Nicoop/CNC_Laser_micro/Documentation/Entregables/LaTeX files/main.tex

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

%% Packages
\usepackage{amsmath}
\usepackage{lmodern}
\setlength{\headheight}{38pt}
\addtolength{\topmargin}{-20pt}
\usepackage{tabularx}
\usepackage{graphicx}
\usepackage[spanish,es-nodecimaldot]{babel}
\usepackage{tikz}
\usetikzlibrary{arrows.meta,positioning,shapes.geometric}
\usepackage{pdflscape}
\usepackage{xurl}
\usepackage[section]{placeins}
\usepackage{textcomp}
\addto\captionsspanish{\renewcommand{\refname}{Referencias}\renewcommand{\tablename}{Tabla}}

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

\begin{document}

%% Abstract and keywords must be defined BEFORE \maketitle
\begin{abstract}

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

\end{abstract}

%% Maketitle creates full-width header with abstract and keywords, then starts two-column layout
\maketitle
\normalsize

\onecolumn
\raggedbottom
\setlength{\emergencystretch}{1.5em}
{\small\setlength{\parskip}{0pt}\tableofcontents}
\clearpage
% \twocolumn

\newpage

\section{Introducción y objetivos}
\label{sec:introduccion}

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

\subsection{Objetivo general}

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

\subsection{Objetivos específicos}

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

% ============================================================================= %
\section{Descripción general del sistema}

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

% ============================================================================= %

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

\section{Sistema mecánico, hardware e interfaces eléctricas}
\label{sec:hardware}

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

\begin{figure}[htbp]
    \centering
    
    
    \caption{Diseño mecánico de referencia y recorrido de correas CoreXY~\cite{estructura_thingiverse}. Las imágenes ilustran la arquitectura adoptada; no constituyen fotografías del prototipo láser ni representan su mecanismo Z definitivo.}
    \label{fig:armadura}
\end{figure}

\subsection{Microcontrolador seleccionado}

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

\begin{figure}[htbp]
    \centering
    
    
    \caption{Esquema funcional de las dos bobinas de un motor bipolar. Las letras identifican extremos de bobina; no establecen el orden de terminales ni los colores del motor instalado.}
    \label{fig:NEMA17}
\end{figure}

\subsection{Láser seleccionado}

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

Las principales características declaradas
por el fabricante se presentan en
la Tabla~\ref{tab:caracteristicas_laser}.

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

\subsection{Drivers seleccionados}
\label{subsec:drivers}

\subsubsection{TB6600 -- Accionamiento de los motores}

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

\paragraph{Interfaz de comando.}

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

\paragraph{Configuración de corriente y micropasos.}

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

\paragraph{Características eléctricas.}

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

\begin{figure}[htbp]
    \centering
    
    \hspace{2cm}
    
    \caption{Aspecto ilustrativo de un módulo TB6600. El conexionado de la CNC se presenta en la Figura~\ref{fig:esquematico-electrico}.}
    \label{fig:TB6600}
\end{figure}

\subsubsection{P-DA-01 -- Interfaz del láser}

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

\subsection{Conexiones eléctricas}

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

\clearpage

% ============================================================================= %
\section{Arquitectura del firmware}
\label{sec:arquitectura}

\subsection{Organización modular}

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

\subsection{Inicialización y programa principal}

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

\subsection{Representación de los estados de operación}

El funcionamiento de la aplicación se representa mediante
el diagrama unificado de la Figura~\ref{fig:flujo-firmware}.
Se trata de un modelo funcional obtenido a partir del flujo
de control y de las banderas del programa; no corresponde
a una máquina de estados implementada mediante una única
variable de estado.

El recorrido principal comprende la inicialización,
el servicio del bucle y el procesamiento de las líneas
recibidas. Antes de interpretar cada línea se reconoce
el comando \texttt{\$X} y se comprueba la bandera de alarma.
Con alarma activa, las demás líneas son rechazadas.
El bucle continúa atendiendo los mensajes de estado
y bienvenida, así como la recepción UART. Las llamadas
bloqueantes de movimiento y referenciación retornan
al punto desde el que fueron invocadas.

La atención de un final de carrera es asíncrona.
Fuera del \textit{homing}, cuando la entrada permanece
activa durante la comprobación de 200~\textmu s,
se solicita detener los movimientos, se deshabilitan
el láser y los motores, se descarta el segmento pendiente
y se activa la alarma. La línea discontinua del diagrama
indica la modificación de esta condición; no representa
un salto del programa principal hacia otro bucle
de ejecución.

El retorno de la interrupción permite continuar
el contexto interrumpido. Por ello, el bloqueo de nuevas
líneas no equivale a cancelar todo el procesamiento
de una instrucción ya iniciada. Además, la ejecución
por tiempo de espera del segmento pendiente no comprueba
por sí misma la bandera de alarma. Estas particularidades
delimitan el alcance de la protección implementada
y justifican revisar la inhibición del movimiento
en todas las rutas de ejecución ante una alarma.

\begin{landscape}
    \begin{figure}[p]
        \centering

        \resizebox{\linewidth}{!}{%
            \input{attachments/estados-firmware}%
        }

        \caption{Diagrama funcional unificado del firmware.
        Las flechas continuas representan el flujo principal;
        el enlace discontinuo muestra el efecto de la
        interrupción de límite sobre la condición de alarma.
        Las operaciones agrupadas en el bloque de procesamiento
        se ejecutan según la instrucción recibida.}

        \label{fig:flujo-firmware}
    \end{figure}
\end{landscape}
% ============================================================================= %

\section{Comunicación e interpretación de G-code}
\label{sec:comunicacion}

\subsection{Generación y envío de instrucciones mediante LaserGRBL}

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

\subsection{Comunicación serie y tratamiento de mensajes}

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

\subsection{Interpretación de las instrucciones}

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

\subsection{Comandos reconocidos y estado modal}

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

\subsection{Anticipación de segmentos mediante lookahead}
\label{subsec:lookahead}

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

\[
c = \hat{\mathbf{d}}_{\mathrm{pendiente}}
    \cdot \hat{\mathbf{d}}_{\mathrm{nuevo}}.
\]

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

\subsection{Alcance de la compatibilidad con LaserGRBL}

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

% ============================================================================= %
\section{Generación y coordinación del movimiento}
\label{sec:movimiento}

\subsection{Cinemática y elección del mecanismo CoreXY}

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

\paragraph{Criterios de elección.}

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

\paragraph{Principio de funcionamiento.}

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

La transformación cinemática directa
se expresa como:

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

\paragraph{Transformación de las consignas.}

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

\paragraph{Ventajas y limitaciones.}

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

\subsection{Conversión de desplazamientos en pulsos}

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

Para una polea dentada, el factor se calcula mediante:

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

\begin{equation}
    K_s =
    \frac{200 \times 16}{20 \times 2}
    = 80\,\mathrm{pulsos/mm}.
\end{equation}

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

A partir del desplazamiento solicitado, las cantidades
de pulsos con signo se determinan como:

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

\subsection{Interpolación y sincronización de los motores}

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

\begin{equation}
    N_A = 1200,
    \qquad
    N_B = 400.
\end{equation}

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

\subsection{Temporización y perfil de velocidad}

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

\begin{equation}
    v = \frac{F}{60}.
\end{equation}

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

La longitud del desplazamiento solicitado se obtiene
mediante:

\begin{equation}
    L = \sqrt{(\Delta x)^2 + (\Delta y)^2}.
\end{equation}

Para una velocidad cartesiana nominal $v$, la
frecuencia de eventos del motor principal resulta:

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

\begin{equation}
    v_p^2 = 2a_p n,
\end{equation}

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

\subsection{Ejecución del barrido de grabado}

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

\subsection{Movimiento independiente del eje Z}

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

\subsection{Resolución y exactitud del posicionamiento}

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

% ============================================================================= %
\section{Referenciación, límites y control del láser}
\label{sec:referenciacion-laser}

\subsection{Referenciación de los ejes}

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

\subsection{Finales de carrera y bloqueo por alarma}

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

\subsection{Límites del espacio de trabajo}

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

\subsection{Accionamiento y modulación del láser}

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

% ============================================================================= %
\section{Ensayos y resultados}
\label{sec:ensayos}

\subsection{Alcance de las pruebas}

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

\subsection{Referenciación y respuesta a límites}

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

\subsection{Prueba de grabado}

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

\subsection{Síntesis de los resultados}

La Tabla~\ref{tab:resultados-observados} resume
las comprobaciones disponibles y el alcance
de sus conclusiones.

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

% ============================================================================= %
\section{Limitaciones y conclusiones}
\subsection{Limitaciones y alcance de la validación}
\label{subsec:limites-validacion}

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

\subsection{Mejoras previstas}

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

\subsection{Conclusiones}
\label{subsec:conclusiones}

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

% ============================================================================= %

% Agradecimientos: incorporar solamente si corresponde al proyecto.

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

\end{document}
