Nicoop/CNC_Laser_micro/Documentation/main.pdf

Facultad de Ingeniería - UNCuyo | Mendoza, Argentina

INFORME DE PROYECTO

# Diseño e implementación de una CNC láser controlada mediante una placa NUCLEO-F446RE

Nicolas Patricelli¹

Federico Barrios Retta²

1Facultad de Ingeniería, Universidad Nacional de Cuyo, Argentina 2Facultad de Ingeniería, Universidad Nacional de Cuyo, Argentina

Resumen

Se presenta el diseño y la implementación de una CNC láser basada en una placa NUCLEO-F446RE. El firmware interpreta instrucciones G-code enviadas desde LaserGRBL, coordina el movimiento CoreXY y el eje Z mediante motores paso a paso y genera el mando PWM del cabezal. Se describen la estructura mecánica, las interfaces eléctricas, la organización modular, la referenciación y el tratamiento de límites. Las pruebas funcionales permitieron completar el homing de los tres ejes, observar la detención ante finales de carrera y obtener un grabado sobre MDF de 5 mm de espesor nominal. La validación disponible es cualitativa: no se determinaron valores de exactitud o repetibilidad y no se considera validada la capacidad de corte. Se identifican las limitaciones de la implementación y las mejoras de protección, acondicionamiento y diagnóstico previstas.

1

UNCUYO – Ingeniería Mecatrónica Mendoza – Argentina

[Microcontroladores y Electrónica de Potencia] Proyecto Integrador de la Materia

Prof. Titular: Eduardo Iriarte Prof. JTP: Martín
Alumnos: Patricelli Nicolas, Barrios Retta Federico

Índice

1. Introducción y objetivos | 3
2. Descripción general del sistema | 3
3. Sistema mecánico, hardware e interfaces eléctricas | 4
4. Arquitectura del firmware | 12
5. Comunicación e interpretación de G-code | 16
6. Generación y coordinación del movimiento | 19
7. Referenciación, límites y control del láser | 23
8. Ensayos y resultados | 25
9. Limitaciones y conclusiones | 26

### 1. Introducción y objetivos

El grabado mediante láser requiere que el desplazamiento relativo entre la herramienta y la pieza sea coordinado con el accionamiento del láser. Para ejecutar una trayectoria definida, deben ser interpretadas las instrucciones de trabajo y generadas las señales que gobiernan los actuadores de la máquina.

En el marco de la asignatura Microcontroladores y Electrónica de Potencia, se desarrolló el control de una CNC destinada al grabado y corte láser. El proyecto permite integrar los contenidos relacionados con la programación de sistemas embebidos, la comunicación serie, la utilización de sensores y el accionamiento de motores paso a paso.

### 1.1. Objetivo general

Diseñar e implementar un sistema de control basado en un microcontrolador para ejecutar trayectorias de grabado mediante láser a partir de instrucciones enviadas desde una computadora.

### 1.2. Objetivos específicos

Se plantean como objetivos específicos la interpretación de las instrucciones de trabajo, la coordinación de los desplazamientos en el plano de grabado, el ajuste de la distancia relativa entre el láser y la pieza, y la regulación del accionamiento del láser durante la ejecución de las trayectorias.

Asimismo, se busca establecer una referencia de posición mediante sensores de fin de carrera y verificar el funcionamiento del sistema mediante ensayos de movimiento y grabado.

### 2. Descripción general del sistema

La máquina desarrollada consiste en un sistema de control numérico computarizado (CNC) destinado al grabado y al corte mediante láser. Durante estos procesos, el cabezal es desplazado respecto de la pieza siguiendo una trayectoria definida por instrucciones G-code, mientras que el accionamiento del láser es coordinado con el movimiento.

El posicionamiento del cabezal en el plano X–Y se realiza mediante un mecanismo de cinemática CoreXY, accionado por dos motores paso a paso. Se incorpora, además, un eje Z que permite desplazar el cabezal para ajustar la distancia entre el módulo láser y la superficie de trabajo. El eje Z es accionado de manera independiente de los desplazamientos coordinados en el plano X–Y.

Las trayectorias de trabajo son definidas mediante un archivo G-code generado en una computadora. Las instrucciones son transmitidas al microcontrolador STM32 de una placa NUCLEO-F446RE, donde son interpretadas para generar las señales de paso, dirección y habilitación de los drivers de los motores. Asimismo, se genera una señal de modulación por ancho de pulso (PWM) destinada a comandar el accionamiento del módulo láser.

El sistema incorpora finales de carrera para establecer una referencia de posición mediante un procedimiento de referenciación o homing. A partir de dicha referencia, los desplazamientos son determinados mediante las consignas y los pasos comandados a los motores. El posicionamiento se realiza en lazo abierto, sin medición continua de la posición del cabezal.

La Figura 1 resume los bloques funcionales y distingue las consignas de movimiento, el mando del láser y las entradas de referencia.

Computadora LaserGRBL; NUCLEO-F446RE Firmware propio; Tres TB6600 Canales A, B y Z; STEP / DIR / ENA; Cuatro motores Dos CoreXY y dos Z; P-DA-01 Interfaz del láser; LT-40W-F23 Cabezal láser; Tres finales de carrera X, Y y Z; UART USB; GPIO; bobinas; PWM

Figura 1. Bloques funcionales de la CNC. Las conexiones de potencia y las referencias eléctricas se detallan en la Figura 8.

### 3. Sistema mecánico, hardware e interfaces eléctricas

### 3.1. Armadura de la CNC

La armadura se construyó a partir del diseño Core XY, publicado por Javierarnedo en Thingiverse [1]. Se conservaron los perfiles y la configuración del bastidor. No se dispone de un relevamiento dimensional del montaje; los límites configurados en el firmware no se utilizan como medidas del bastidor ni como recorridos útiles comprobados.

Se utilizaron perfiles ranurados de aluminio, dispuestos en dos marcos rectangulares unidos mediante cuatro montantes. Las uniones atornilladas y las escuadras permiten fijar los soportes de guiado y transmisión. La alineación del bastidor y la ausencia de holguras en las uniones condicionan la geometría del recorrido.

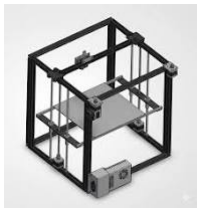
[picture p27: figure]
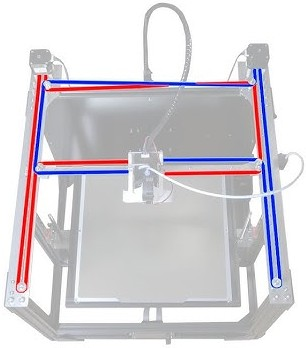
[picture p28: figure]

Figura 2. Diseño mecánico de referencia y recorrido de correas CoreXY [1]. Las imágenes ilustran la arquitectura adoptada; no constituyen fotografías del prototipo láser ni representan su mecanismo Z definitivo.

### 3.2. Microcontrolador seleccionado

El sistema de control fue implementado mediante una placa de desarrollo NUCLEO-F446RE, que incorpora un microcontrolador STM32F446RET6 de la familia STM32F4. Este dispositivo dispone de un núcleo Arm Cortex-M4 de 32 bits, con unidad de punto flotante de precisión simple, 512 KB de memoria Flash y 128 KB de memoria SRAM [9].

La unidad de punto flotante proporciona soporte para las operaciones aritméticas empleadas en el procesamiento de coordenadas y en los cálculos de movimiento. Aunque el microcontrolador admite una frecuencia máxima de 180 MHz, en la configuración del proyecto se utiliza un reloj de sistema de 84 MHz.

Para la temporización del movimiento se utilizan los temporizadores TIM2 y TIM4, asociados a la generación de pasos de los motores del mecanismo CoreXY y del eje Z, respectivamente. El canal 1 del temporizador TIM3 se utiliza para generar la señal PWM que comanda el módulo láser.

La comunicación con la computadora se realiza mediante USART2, configurada a 115200 bit/s. La interfaz de puerto serie virtual de la placa permite establecer esta comunicación a través de la conexión USB del ST-LINK. Asimismo, este dispositivo integrado permite programar y depurar el microcontrolador durante el desarrollo.

Las señales de paso, dirección y habilitación de los drivers se generan mediante pines GPIO. También se utilizan entradas digitales para recibir las señales de los finales de carrera. Los conectores de expansión de la placa permiten acceder a los pines necesarios para estas interfaces.

La disponibilidad de temporizadores, comunicación serie, salidas PWM y pines de entrada y salida permite concentrar en un mismo microcontrolador la interpretación de instrucciones, la coordinación del movimiento y el comando de los actuadores.


Figura 3. Referencia mecánica de la placa NUCLEO-64 y asignación de conectores. Para el proyecto se utiliza la variante F446RE; las señales empleadas se reúnen en la Tabla 4.

### 3.3. Motores seleccionados

Para el accionamiento de la máquina se utilizaron cuatro motores paso a paso bipolares de tamaño de brida NEMA 17, marca Usongshine, modelo 17HS3401.

Dos motores accionan el mecanismo CoreXY, correspondientes a los canales A y B. Los otros dos se utilizan para el desplazamiento del eje Z y se conectan en paralelo a un mismo driver.

Cada motor dispone de dos bobinas, cuyo accionamiento requiere invertir el sentido de la corriente para establecer la secuencia de excitación. Esta función es realizada por los módulos TB6600, mientras que el microcontrolador genera las señales de paso, dirección y habilitación.

La denominación NEMA 17 identifica el tamaño de la brida de montaje y no determina por sí sola la corriente nominal, el ángulo de paso ni el par disponible. No se dispone de la ficha específica de corriente y par del ejemplar instalado; estos datos no se deducen del tamaño de brida.

Tabla 1. Identificación y características de los motores utilizados.

Parámetro | Identificación o valor
Marca | Usongshine
Modelo | 17HS3401
Tamaño de brida | NEMA 17
Tipo de accionamiento | Bipolar, dos fases
Cantidad instalada | Cuatro motores
Lote relevado | 202331120
Ángulo utilizado por el firmware | 1,8 ◦
Corriente y par nominales | Sin ficha específica disponible

En el firmware se utiliza un ángulo de paso de 1,8

◦
, equivalente a 200 pasos completos por revolución, y una subdivisión de

1/16 de paso. La conversión a pulsos por revolución y por milímetro se desarrolla en la Sección 6. Estos parámetros deben coincidir con el ángulo nominal del motor y con el ajuste de micropaso seleccionado en los drivers.

El ajuste eléctrico y su relación con la conexión de los motores se describen en la Subsección 3.5. No se dispone de un registro de las posiciones DIP utilizadas.

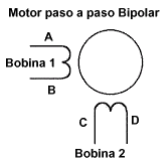
[picture p29: figure]

Figura 4. Esquema funcional de las dos bobinas de un motor bipolar. Las letras identifican extremos de bobina; no establecen el orden de terminales ni los colores del motor instalado.

### 3.4. Láser seleccionado

Como herramienta de trabajo se utiliza un módulo láser LASER TREE LT-40W-F23, destinado a operaciones de grabado y corte. El conjunto integra el emisor láser, la óptica de enfoque, la electrónica de accionamiento y un sistema de refrigeración mediante disipador y ventilador.

Según la documentación del fabricante [2], su potencia óptica es de 5 ± 1 W y su longitud de onda es de 450 ± 10 nm, correspondiente a la región azul del espectro visible. La denominación LT-40W-F23 identifica el modelo y no debe interpretarse como una potencia óptica de 40 W.

Las principales características declaradas por el fabricante se presentan en la Tabla 2.

Tabla 2. Características declaradas del módulo láser LASER TREE LT-40W-F23.

Parámetro | Especificación
Potencia óptica | 5 ± 1 W
Longitud de onda | 450 ± 10 nm
Tensión de alimentación | 12 V CC
Corriente de entrada | 1,5–2 A
Distancia de enfoque declarada | 23 mm
Frecuencia de modulación | Hasta 5 kHz
Nivel de mando indicado | 0/5–12 V
Temperatura de operación | 0–60 ◦C
Conector | XH2.54 de tres terminales
Masa del módulo | 230 g

La interfaz del cabezal utiliza tres conductores: alimentación positiva, referencia GND y entrada PWM. Esta disposición permite mantener la alimentación del módulo y modificar su accionamiento mediante la señal de control, sin utilizar la salida del microcontrolador para suministrar la corriente del emisor.

El cabezal se encuentra montado sobre el mecanismo de desplazamiento del eje Z. Este movimiento permite ajustar su posición respecto de la pieza para establecer la condición de enfoque. Para el grabado, el fabricante indica que el foco debe situarse sobre la superficie del material. La referencia mecánica utilizada para realizar ese ajuste debe respetar las indicaciones de montaje del módulo.

El accionamiento se establece mediante PWM; los modos y la relación entre consigna y salida se desarrollan en la Sección 7. La potencia óptica indicada en la tabla es un dato del fabricante, no una medición del proyecto.


Figura 5. Cabezal LT-40W-F23, accesorios y dimensiones de referencia del fabricante. Estas imágenes de producto no son fotografías del montaje experimental.

La posibilidad de grabar o cortar una pieza depende del material, su espesor, el enfoque, la velocidad de avance y la consigna de accionamiento. Por ello, las prestaciones de la máquina deben establecerse mediante ensayos, sin deducirse únicamente de la potencia nominal del cabezal.

### 3.5. Drivers seleccionados

### 3.5.1. TB6600 – Accionamiento de los motores

Para el accionamiento de los motores paso a paso se utilizaron módulos driver comercializados como TB6600. Su función consiste en recibir las señales de comando generadas por el microcontrolador y establecer la excitación de los bobinados necesaria para producir el movimiento.

Mediante estos módulos se distingue la generación de las consignas de movimiento del suministro de energía a los motores. El microcontrolador determina la cantidad de pulsos, su frecuencia y el sentido de desplazamiento, mientras que el driver gobierna las corrientes de los bobinados a partir de su alimentación de potencia.

Interfaz de comando. El movimiento se comanda mediante las entradas PUL y DIR. Cada pulso válido recibido en PUL produce un avance en la secuencia de excitación, cuya magnitud depende de la subdivisión de pasos seleccionada. La entrada DIR establece el sentido de avance de dicha secuencia. Además, se dispone de una entrada ENA para controlar la habilitación del accionamiento.

Las entradas de comando se presentan mediante pares de terminales PUL+/PUL-, DIR+/DIR- y ENA+/ENA-. Según las especificaciones disponibles, estas entradas son optoacopladas y están destinadas a señales de 5 V, con una corriente de señal comprendida entre 8 y 15 mA. Por lo tanto, su conexionado debe considerar tanto la tensión aplicada como la corriente requerida por la interfaz de entrada.

Configuración de corriente y micropasos. El módulo permite seleccionar la corriente de salida mediante interruptores DIP. Este ajuste establece el nivel de corriente utilizado para la excitación de los bobinados y debe determinarse a partir de las características del motor conectado. La corriente máxima admitida por el driver no constituye, por sí sola, el valor que debe utilizarse en el proyecto.

También puede seleccionarse la subdivisión de pasos. En el funcionamiento por micropasos, las corrientes de los bobinados son modificadas para generar posiciones intermedias entre los pasos completos del motor. Esto permite incrementar la cantidad de pulsos requeridos por vuelta y reducir el incremento angular nominal asociado a cada pulso.

La posición de los interruptores debe corresponder a la subdivisión utilizada por el firmware. En Z, la corriente del driver se reparte entre los dos motores conectados en paralelo; por ello, el ajuste debe considerar las dos ramas y no solamente un motor. La conversión de micropasos a desplazamiento se desarrolla en la Sección 6.

Características eléctricas. En la Tabla 3 se resumen las especificaciones recopiladas para el módulo. La alimentación del montaje se documenta en el esquema de conexiones. Los demás valores proceden de la información comercial recopilada; no se dispone de una ficha que identifique la versión del módulo ni de un registro de sus ajustes DIP.

Parámetro | Valor declarado
Tensión de alimentación de potencia | 9–42 V CC
Intervalo de corriente de salida | 0,7–4,0 A
Niveles de corriente seleccionables | 8
Frecuencia máxima de pulsos de entrada | Hasta 20 kHz
Tensión de las señales de entrada | 5 V
Corriente de las señales de entrada | 8–15 mA
Pulsos por vuelta para un motor de 1,8
- 200–6400
Aislamiento de las entradas | Optoacoplado
Protecciones declaradas | Sobrecorriente y sobretemperatura

Tabla 3. Especificaciones recopiladas del módulo TB6600 según la información comercial aportada. No se identifica la revisión del módulo ni si la corriente declarada es pico o eficaz.

La frecuencia de PUL gobierna la velocidad de la secuencia de excitación. El límite de 20 kHz es un dato declarado para el módulo, no una velocidad experimental de la CNC; el par disponible también depende de la alimentación, la corriente y la velocidad.


Figura 6. Aspecto ilustrativo de un módulo TB6600. El conexionado de la CNC se presenta en la Figura 8.

### 3.5.2. P-DA-01 – Interfaz del láser

La conexión entre el sistema de control, la alimentación y el cabezal láser se realiza mediante una placa adaptadora P-DA-01. Su función es facilitar la interconexión de estos elementos mediante conectores de alimentación y de señal TTL/PWM.

Debe distinguirse esta placa del driver propio del cabezal, encargado del accionamiento del diodo láser. La P-DA-01 constituye una interfaz de conexión y distribución de alimentación [2]; la documentación disponible no permite atribuirle funciones de regulación de corriente ni de aislamiento galvánico.

La placa dispone de distintas entradas para adaptar el conexionado de la unidad de control y de salidas de tres terminales hacia el módulo láser. Estas últimas comprenden la alimentación positiva, la referencia GND y la señal de mando PWM. También incorpora una entrada de alimentación externa de corriente continua y un selector EXT/INT, mediante el cual se selecciona la alimentación externa o la procedente del conexionado de entrada. Dos indicadores luminosos permiten comprobar la presencia de alimentación y de la señal de control.

En el firmware del proyecto, la señal de mando del láser es generada por el canal 1 del temporizador TIM3 y se encuentra asignada al pin PC6 del microcontrolador. Su frecuencia es de 1 kHz y su ciclo de trabajo se modifica para establecer la consigna de accionamiento del cabezal. La alimentación del láser es suministrada por la fuente de la máquina, mientras que la salida del microcontrolador proporciona únicamente la señal de mando.


Figura 7. Interfaz P-DA-01 y descripción ilustrativa de sus conexiones. La cantidad de terminales puede variar entre revisiones; el orden del montaje no se deduce únicamente de la imagen

### 3.6. Conexiones eléctricas

Las interconexiones entre la placa de desarrollo, los drivers de los motores, los finales de carrera y el módulo de accionamiento del láser se representan en la Figura 8. El esquema fue elaborado en KiCad e identifica los terminales de los módulos, las redes de alimentación y las señales de control utilizadas por el firmware.

Distribución de la alimentación. Se dispone de una fuente con entrada de 220 V de corriente alterna y salidas de 24 V, 12 V y 5 V de corriente continua. La salida de 12 V también se representa como alimentación del cabezal, en correspondencia con la tabla específica del LT-40W-F23. Aunque los diagramas genéricos del manual mencionan 12/24 V, esa indicación no se interpreta como autorización para alimentar este modelo con 24 V. La alimentación de potencia de los drivers TB6600 se realiza mediante la salida de 12 V, con los tres módulos conectados en paralelo. La placa NUCLEO-F446RE se alimenta desde la computadora mediante la conexión USB del ST-LINK, que también proporciona el puerto serie virtual.

En el esquema se distinguen las alimentaciones de potencia, las tensiones utilizadas por las interfaces de control y sus correspondientes retornos. Las uniones entre referencias eléctricas se representan según el cableado del sistema.

Interfaz con los drivers de los motores. El accionamiento de los motores es comandado mediante señales de paso, dirección y habilitación. Las señales de paso y dirección son independientes para los canales A, B y Z, mientras que la habilitación es compartida por los tres drivers.

El cableado documentado en el firmware corresponde a una conexión de ánodo común: los terminales PUL+, DIR+ y ENA+ se conectan a 3,3 V, y los terminales negativos reciben las señales de los GPIO. La correspondencia entre señales y pines se presenta en la Tabla 4. El uso de 3,3 V difiere del nivel comercial declarado de 5 V para los TB6600. Sin el circuito de entrada de la versión instalada ni mediciones de corriente y umbral, no se afirma que el conexionado proporcione los márgenes eléctricos requeridos.

Conexión de los motores. Cada motor bipolar dispone de dos bobinas. Los terminales A+ y A- del driver se conectan a los extremos de una bobina, y los terminales B+ y B-, a los extremos de la otra.

Los motores CoreXY se identifican como M1 (A) y M2 (B) en el esquema. Cada uno dispone de un driver; estas letras deben distinguirse de A+/A- y B+/B-, que identifican las bobinas. Para el eje Z, el firmware documenta dos motores conectados en paralelo a un mismo driver. El esquema muestra las ramificaciones de cada salida hacia M3 y M4, correspondientes a los dos motores de Z.

Tabla 4. Asignación de señales de control y entradas de límite en la NUCLEO-F446RE.

Señal | GPIO | Destino o procedencia
STEP_A | PC0 | PUL- del driver A
DIR_A | PC1 | DIR- del driver A
STEP_B | PC2 | PUL- del driver B
DIR_B | PC3 | DIR- del driver B
STEP_Z | PC4 | PUL- del driver Z
DIR_Z | PC5 | DIR- del driver Z
MOTOR_EN | PC7 | ENA- de los tres drivers
LIMIT_X | PB0 | Señal del final de carrera X
LIMIT_Y | PB1 | Señal del final de carrera Y
LIMIT_Z | PB2 | Señal del final de carrera Z
LASER_PWM | PC6 | Entrada de control del módulo láser

Interfaz con los finales de carrera. Se utilizan tres señales de límite, correspondientes a X, Y y Z, conectadas a PB0, PB1 y PB2, respectivamente. Los módulos de final de carrera se representan mediante sus terminales de alimentación, masa y señal, conservando la identificación del conector utilizado.

El firmware configura estas entradas con resistencias internas de polarización a masa e interpreta un nivel bajo como la activación del límite. Por lo tanto, debe comprobarse que la salida de los módulos presente el nivel de reposo y de activación esperado por el programa. El esquema identifica alimentación de 3,3 V, masa y señal. No se dispone de la identificación exacta del módulo ni de un relevamiento del orden de terminales; el funcionamiento observado no sustituye esa caracterización.

Interfaz con el accionamiento del láser. La señal de control del láser se genera mediante el canal 1 de TIM3 y se obtiene en PC6, disponible en el terminal 4 del conector CN10 de la NUCLEO-F446RE. Esta red se identifica como LASER_PWM.

La temporización del PWM se describe en la Sección 7. La red PC6 llega a la interfaz P-DA-01 y no directamente al diodo láser. El manual identifica una entrada PWM de 0/5–12 V, pero no especifica un umbral que garantice el reconocimiento de 3,3 V. No se dispone de una caracterización eléctrica de esta conexión; se registra como limitación en la Subsección 9.1.

# Tb6600 Signal High Voltage PUL+

# VCC U1

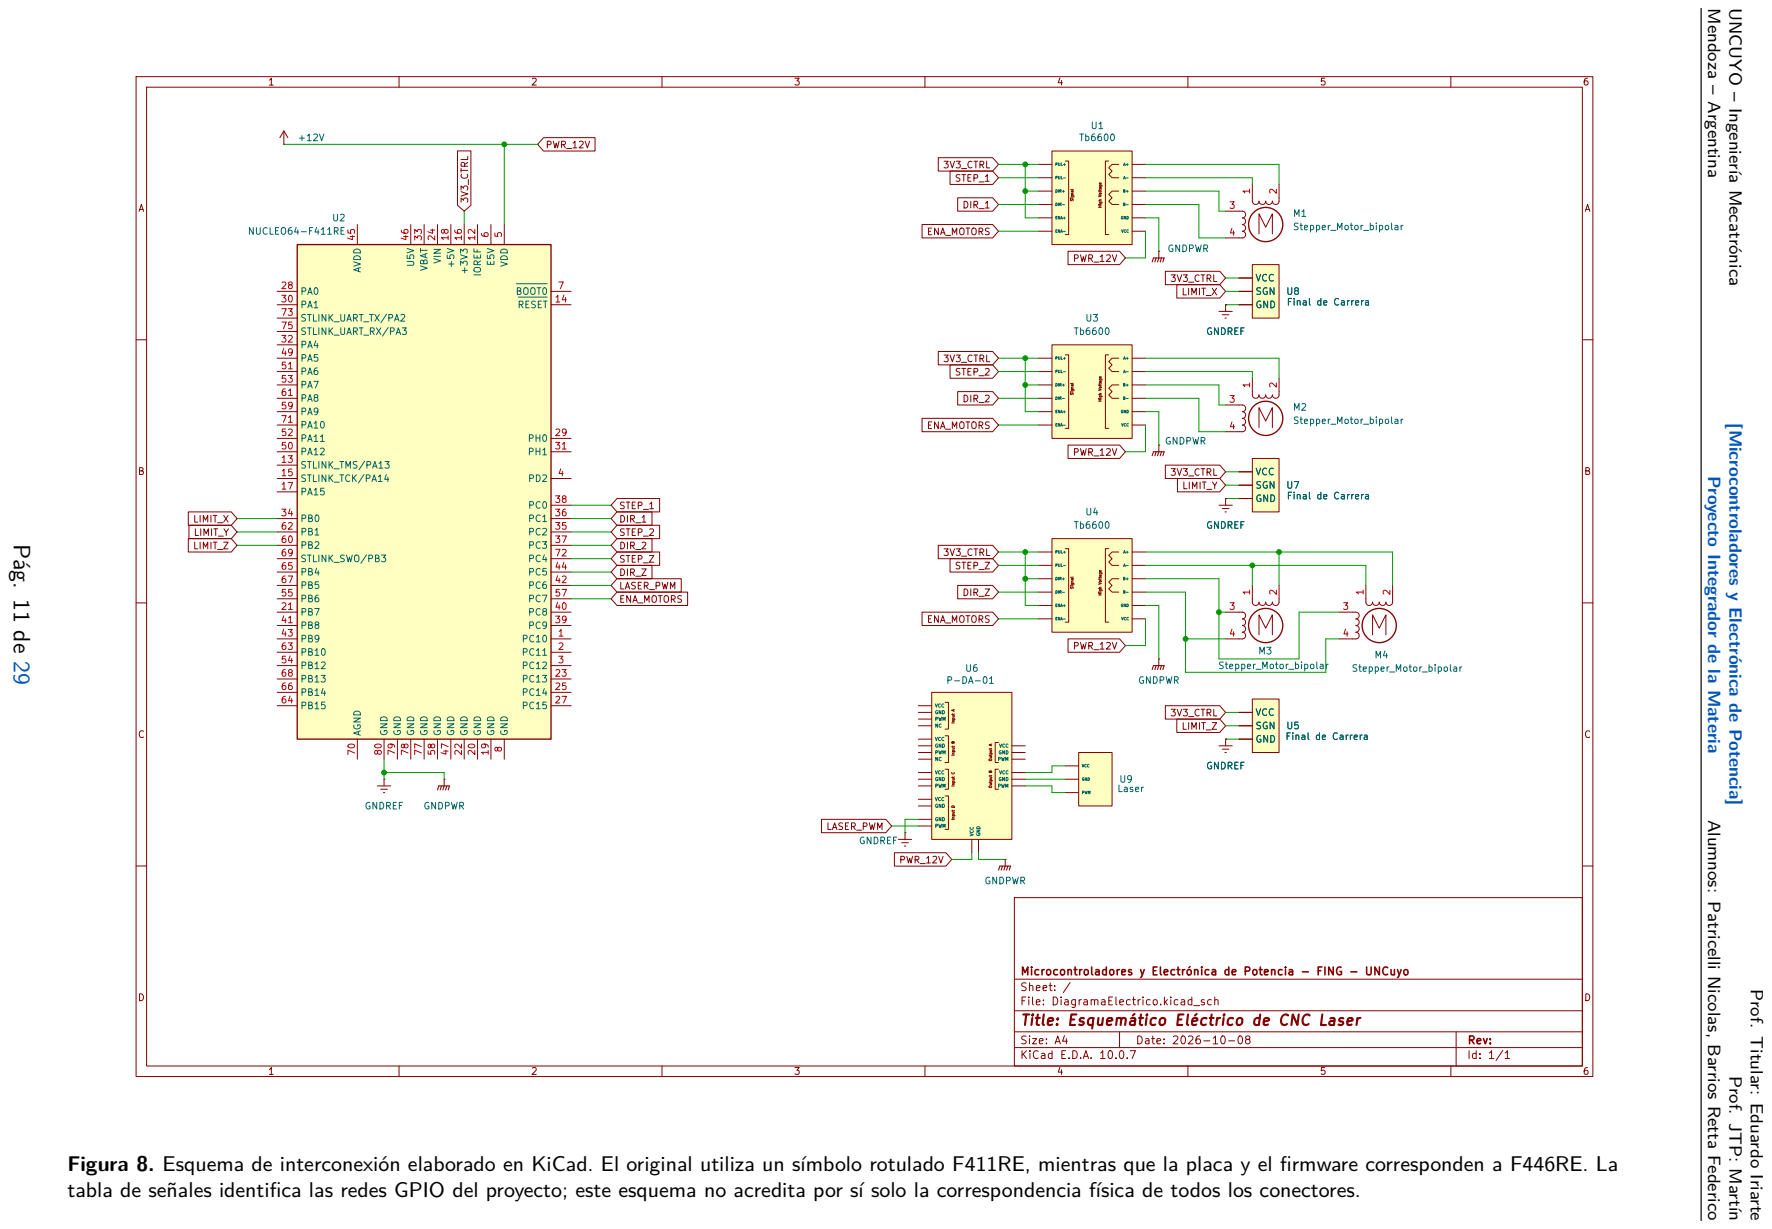
[picture p30: page 11]

UNCUYO – Ingeniería Mecatrónica [Microcontroladores y Electrónica de Potencia]

Alumnos: Patricelli Nicolas, Barrios Retta Federico 1 2 3 4 5 6 1 2 3 4 5 6 ABCD ABCD Date: 2026-10-08

Final de Carrera GNDPWR

Proyecto Integrador de la Materia

GNDREF Figura 8. Esquema de interconexión elaborado en KiCad. El original utiliza un símbolo rotulado F411RE, mientras que la placa y el firmware corresponden a F446RE. La tabla de señales identifica las redes GPIO del proyecto; este esquema no acredita por sí solo la correspondencia física de todos los conectores.

Sheet: /
File: DiagramaElectrico.kicad_sch
Title: Esquemático Eléctrico de CNC Laser
KiCad E.D.A. 10.0.7

Prof. Titular: Eduardo Iriarte

### 4. Arquitectura del firmware

### 4.1. Organización modular

El firmware fue desarrollado en lenguaje C mediante una organización modular. Las responsabilidades del sistema se distribuyen entre módulos de interpretación de instrucciones, generación de movimiento, referenciación, control del láser y habilitación de los drivers.

Los módulos funcionales se organizan mediante archivos de encabezado, en los que se declara su interfaz pública, y archivos de implementación, en los que se definen las operaciones correspondientes. Los encabezados de configuración reúnen constantes y asignaciones de pines, sin requerir necesariamente un archivo de implementación.

El estado interno y las funciones auxiliares de los módulos se mantienen, cuando corresponde, mediante declaraciones con el especificador static. En las declaraciones a nivel de archivo, este especificador establece enlace interno y evita que sus identificadores sean utilizados directamente desde otras unidades de compilación. De esta manera, el acceso al módulo se realiza mediante las funciones declaradas en su encabezado.

Las variables locales declaradas con static conservan su valor entre llamadas sucesivas. Este recurso es utilizado, por ejemplo, para recordar las condiciones de continuidad entre segmentos de movimiento. El ocultamiento del estado interno permite modificar su representación sin alterar la interfaz utilizada por los demás módulos.

Las dependencias funcionales se muestran en la Figura 10. Cada bloque representa un módulo C con una interfaz propia. Las marcas de visibilidad son una adaptación gráfica y no implican una implementación orientada a objetos.

La Figura 9 muestra una selección de archivos de la carpeta Code/, utilizada tanto en la copia local como en el repositorio revisado. El contraste se realizó con la revisión 0ce7b21, cuyo código fuente coincide con el utilizado en este informe [7].

Code/
|-- CNC_laser.ioc
|-- Core/
| | |-- Inc/
| | | | |-- main.h, corexy_config.h
| | | | |-- gcode_parser.h, homing.h
| | | | |-- stepper.h, z_axis.h
| | | | |-- laser.h, motor_enable.h, watchdog.h
| | | | ‘-- ... encabezados de soporte
| | |-- Src/
| | | | |-- main.c, gcode_parser.c
| | | | |-- stepper.c, z_axis.c, homing.c
| | | | |-- laser.c, motor_enable.c, watchdog.c
| | | | |-- stm32f4xx_it.c, stm32f4xx_hal_msp.c
| | | | ‘-- ... archivos de soporte
| | ‘-- Startup/
|-- Drivers/
| | |-- CMSIS/
| | ‘-- STM32F4xx_HAL_Driver/
|-- STM32F446RETX_FLASH.ld
‘-- STM32F446RETX_RAM.ld

Figura 9. Estructura seleccionada del proyecto de firmware. Se agrupan nombres en algunas filas y se abrevian los archivos de soporte y las bibliotecas.

Mendoza – Argentina

UNCUYO – Ingeniería Mecatrónica [Microcontroladores y Electrónica de Potencia]

Proyecto Integrador de la Materia

Prof. Titular: Eduardo Iriarte

Prof. JTP: Martín

Alumnos: Patricelli Nicolas, Barrios Retta Federico

MÓDULO C
gcode_parser
Interpretación de una línea de G-code

+ gcode_parse_line(...)

Salida: estructura GcodeCommand. La conversión numérica es interna.

MÓDULO C
main.c
UART, comandos, segmentos pendientes y alarmas

+ main()
- process_gcode_line(...)
- flush_pending_move(...)
- service_realtime()

MÓDULO C
motor_enable
Habilitación común de los drivers

+ motor_enable_init()
+ motors_enable()
+ motors_disable()
+ motors_are_enabled()

MÓDULO C
homing
Referenciación Z, X e Y; lectura de límites

+ homing_init()
+ homing_run()
+ homing_is_active()

Búsqueda directa: pulsos GPIO y DWT.

MÓDULO C
stepper
Movimiento CoreXY e interrupción de TIM2

+ stepper_init(...)
+ stepper_move_to(...)
+ stepper_get_position(...) + stepper_set_position(...) + stepper_emergency_stop()
+ stepper_timer_isr()
+ stepper_set_wait_callback(...)

MÓDULO C
z_axis
Movimiento Z e interrupción de TIM4

+ z_axis_init(...)
+ z_axis_move_to(...)
+ z_axis_get_position(...) + z_axis_set_position(...) + z_axis_emergency_stop()
+ z_axis_timer_isr()

MÓDULO C
watchdog
Supervisión mediante IWDG

+ watchdog_refresh()
+ watchdog_caused_last_reset()

MÓDULO C
laser
Accionamiento PWM mediante TIM3

+ laser_init(...)
+ laser_enable() / laser_disable() + laser_set_power(...)
+ laser_set_dynamic(...)
+ laser_begin_segment(...) + laser_set_speed_ratio(...)
analiza | habilita

ejecuta

modo, potencia y segmento mueve / fija cero

referenciación Z relación de velocidades

callback

refresca

Cómo leer la figura

Llamada a una interfaz
Servicio de supervisión

Invocación de callback

+ Interfaz expuesta por el módulo. - Operación interna de main.c. Se muestran operaciones seleccionadas y firmas abre-

viadas. La callback se ejecuta durante la espera del movimiento X–Y; stepper no depende de un encabe-
zado de main. Figura 10. Organización modular del firmware. Cada bloque identifica un módulo C, su responsabilidad y una selección de sus operaciones. Las flechas indican llamadas a

interfaces; se distinguen las dependencias de supervisión y la invocación mediante callback. Las firmas se presentan abreviadas.

Pág. 13 de 29

Coordinación de la aplicación: main.c. En este archivo se inicializan los periféricos y los módulos funcionales, y se implementa el bucle principal. También se construyen las líneas recibidas, se atienden los comandos especiales y se determinan las acciones correspondientes a las instrucciones G-code. Se conservan el modo de coordenadas, el avance modal, el segmento X–Y pendiente y las banderas asociadas a la comunicación y a la alarma.

Interpretación de instrucciones: gcode_parser. Este módulo transforma una línea de texto en una estructura GcodeCommand. En ella se identifican las coordenadas, el avance, el parámetro de accionamiento del láser y los comandos reconocidos. El módulo realiza la interpretación de la instrucción; la decisión sobre su ejecución y la conservación del estado modal corresponden a la aplicación principal.

Movimiento CoreXY: stepper. Se implementa la transformación de las consignas X–Y en desplazamientos de los motores A y B, junto con la coordinación de los pasos y el perfil de velocidad. El estado del movimiento y las posiciones lógicas se conservan internamente. La generación de pulsos es atendida mediante interrupciones de TIM2, mientras que la interfaz permite solicitar desplazamientos, consultar o establecer la posición lógica y detener el movimiento.

Movimiento del eje Z: z_axis. Se implementa el accionamiento del eje Z mediante consignas de posición y avance. El módulo conserva la posición lógica y el estado del desplazamiento, y actualiza los pasos mediante interrupciones de TIM4. Su ejecución es independiente del mecanismo de almacenamiento y continuidad de segmentos X–Y.

Referenciación: homing. Se implementa la secuencia de búsqueda de los finales de carrera en el orden Z, X e Y. La maniobra comprende una aproximación inicial, un retroceso, una segunda aproximación a menor velocidad y una separación final del contacto. Se utilizan las funciones de movimiento de los módulos CoreXY y Z, y se mantiene una bandera que identifica la ejecución de la referenciación.

Accionamiento del láser: laser. Se administra la habilitación del láser y la actualización del ciclo de trabajo de la señal PWM generada por TIM3. El parámetro S se limita al intervalo configurado y se convierte en un valor de comparación del temporizador. Se distingue entre la deshabilitación del láser y la anulación de su salida durante un movimiento rápido. En modo M4, stepper actualiza la relación entre la velocidad comandada y la de crucero para ajustar el PWM; no se mide la velocidad física.

Habilitación de los drivers: motor_enable. Se administra la señal común de habilitación de los tres drivers y se conserva su estado lógico. La interfaz permite habilitar, deshabilitar y consultar dicho estado, y es utilizada por la aplicación para atender los comandos M17 y M84.

Supervisión: watchdog. El módulo consulta la causa del reinicio y refresca IWDG. Se utiliza desde el servicio principal, las esperas de Z y los retardos del homing. Un reinicio causado por watchdog activa una alarma al arrancar; no restaura la posición física anterior.

Configuración del movimiento: corexy_config.h. Este encabezado reúne las asignaciones de pines y los parámetros de conversión entre desplazamiento y pasos de los motores CoreXY, junto con constantes del perfil de velocidad y límites del área de trabajo. Los parámetros correspondientes al eje Z se encuentran definidos en z_axis.h.

### 4.2. Inicialización y programa principal

Al comenzar la ejecución se inicializa la biblioteca HAL, se configura el reloj del sistema y se establecen los parámetros de los GPIO, USART2 y los temporizadores TIM2, TIM3 y TIM4. También se inicializa el watchdog independiente IWDG.

Posteriormente se inicializan los módulos de referenciación, habilitación de motores, movimiento del eje Z, movimiento CoreXY y control del láser. También se inicia la recepción de datos por interrupción y se transmite el mensaje de bienvenida. Si el reinicio anterior fue provocado por el watchdog, se activa la alarma y se informa la pérdida de referencia de posición. La limpieza mediante $X no sustituye una nueva referenciación, aunque el programa no la exige antes de aceptar otra consigna.

Una vez completada la inicialización, el programa permanece en un lazo principal. En él se atienden los mensajes pendientes, se verifica la condición de ejecución del movimiento X–Y almacenado y se extraen los caracteres del buffer de recepción para construir líneas completas.

Cada línea recibida es procesada mediante la función process_gcode_line(). Los comandos especiales son atendidos directamente, mientras que las instrucciones G-code son analizadas por el módulo gcode_parser. La estructura obtenida es utilizada para determinar las acciones sobre el movimiento, el láser y la habilitación de los motores.

### 4.3. Coordinación de los módulos

main.c mantiene los modos y el segmento pendiente, y solicita la ejecución mediante flush_pending_move(). Esta función fija el estado del láser para el segmento y llama a stepper_move_to(). El tratamiento de instrucciones y la anticipación se desarrollan en la Sección 5; la conversión CoreXY y la temporización, en la Sección 6.

Las consignas Z se ejecutan mediante z_axis_move_to(). El módulo homing utiliza operaciones de CoreXY y Z para referenciar la máquina, mientras que motor_enable administra la señal común de los drivers.

### 4.4. Ejecución mediante interrupciones

Las interrupciones de USART2 reciben los caracteres; las de TIM2 y TIM4 ejecutan los pasos de CoreXY y Z. TIM3 genera el PWM mediante hardware. Las funciones de movimiento esperan a que termine el segmento, mientras las interrupciones habilitadas siguen atendiendo los periféricos.

Durante la espera X–Y, una callback registrada por main.c atiende mensajes y refresca el watchdog. La espera Z y los retardos de homing refrescan el watchdog, pero no invocan ese mismo servicio de mensajes. El procesamiento de nuevas líneas sigue siendo secuencial. Los buffers y la respuesta al programa de computadora se describen en la Sección 5.

Las variables compartidas que lo requieren se declaran volatile. Este calificador expresa accesos que pueden cambiar fuera del flujo observado por el compilador; no sustituye la sincronización ni convierte una secuencia de operaciones en atómica. Su función es distinta del enlace interno establecido por static.

### 4.5. Representación de los estados de operación

La aplicación conserva su estado mediante banderas y estructuras distribuidas, sin una variable global que seleccione todos los modos. El movimiento activo, el segmento pendiente y la alarma representan condiciones distintas. La habilitación del láser, la de motores y el modo de coordenadas pueden coexistir con ellas.

La Figura 11 resume el flujo de llamadas del programa principal. Las rutinas de movimiento son bloqueantes y retornan al punto que las invocó; una interrupción de límite modifica banderas y solicita la detención, pero no elimina por sí sola el resto del procesamiento de una línea ya iniciada.

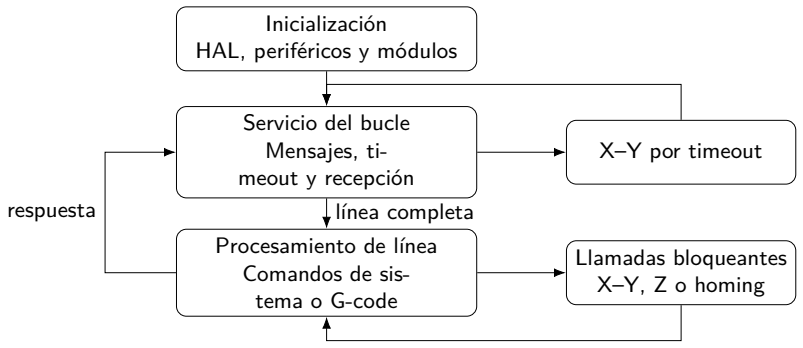
[picture p31: figure]
Inicialización HAL, periféricos y módulos; Servicio del bucle Mensajes, ti- meout y recepción; Procesamiento de línea Comandos de sis- tema o G-code; X–Y por timeout; Llamadas bloqueantes X–Y, Z o homing; respuesta; línea completa

Figura 11. Flujo funcional reconstruido del firmware. Las ramas de X–Y distinguen el retorno al bucle del retorno al procesamiento de la línea.

Una interrupción de límite puede modificar las banderas durante cualquiera de estas llamadas. El retorno al procesamiento interrumpido explica que la alarma no constituya un estado exclusivo que reemplace el flujo de ejecución. El tratamiento de límites y las restricciones de este bloqueo se desarrollan en la Sección 7.

### 5. Comunicación e interpretación de G-code

### 5.1. Generación y envío de instrucciones mediante LaserGRBL

La preparación de los trabajos y el envío de instrucciones a la máquina se realizan mediante LaserGRBL. Este programa permite importar imágenes, establecer parámetros del trabajo y generar una secuencia de instrucciones G-code. También proporciona una interfaz para transmitirlas al controlador y recibir sus respuestas [4].

La utilización de una herramienta existente permite delimitar el desarrollo al sistema embebido encargado de interpretar las consignas y accionar la máquina. La implementación de los algoritmos de procesamiento de imágenes y generación de trayectorias no forma parte del alcance del proyecto. Sin embargo, las instrucciones generadas deben pertenecer al conjunto reconocido por el firmware y utilizar parámetros compatibles con la configuración de la CNC.

En los trabajos de grabado de imágenes pueden generarse secuencias de segmentos lineales con diferentes valores de accionamiento del láser. La ejecución de estas trayectorias requiere conservar el orden de las instrucciones y asociar cada segmento con su consigna de velocidad y de accionamiento. La coordinación mecánica del barrido se desarrolla en la sección de generación de movimiento.

### 5.2. Comunicación serie y tratamiento de mensajes

La comunicación con la computadora se establece mediante USART2, configurada a 115200 bit/s, con ocho bits de datos, un bit de parada y sin paridad. La conexión USB del ST-LINK permite acceder a esta interfaz mediante un puerto serie virtual.

La recepción se realiza por interrupción, de a un carácter. Los caracteres ordinarios son almacenados en un buffer circular y posteriormente extraídos por el programa principal. Al encontrarse un retorno de carro o un salto de línea, se termina la cadena y se procesa la instrucción construida. Las líneas vacías no son enviadas al parser.

El buffer circular dispone de 256 posiciones, de las cuales 255 pueden contener caracteres pendientes. El buffer de construcción de líneas dispone de 96 posiciones, incluyendo el terminador de cadena. Estos límites condicionan la cantidad de información que puede conservarse mientras el programa principal se encuentra ocupado. Si el buffer circular se llena, se descartan los caracteres nuevos; si una línea supera 95 caracteres, su parte restante no se conserva. No se genera un error específico por estas condiciones.

Para mantener el intercambio con LaserGRBL se utilizan respuestas y mensajes con formato compatible con su interfaz [8]: ok, error:n, ALARM:n y [MSG:...]. Las instrucciones que alcanzan el final del procesamiento reciben una respuesta ok; determinados errores producen una respuesta error:n y un retorno anticipado.

La respuesta ok no debe interpretarse como una confirmación de que todos los desplazamientos asociados ya finalizaron. En particular, una consigna X–Y puede haber quedado almacenada como movimiento pendiente cuando se transmite esta respuesta.

Los caracteres ? y 0x18 son tratados por la rutina de recepción sin incorporarse a las líneas G-code. El primero solicita un reporte de estado; el segundo solicita el mensaje de bienvenida y el restablecimiento de los offsets de trabajo. Las acciones correspondientes se atienden mediante banderas y la función service_realtime(), desde el contexto del programa principal.

Durante los movimientos X–Y, esta función también es invocada desde la espera de la rutina de movimiento. De esta manera pueden atenderse solicitudes de estado sin comenzar el procesamiento de otra línea G-code.

### 5.3. Interpretación de las instrucciones

Las instrucciones recibidas son cadenas de caracteres, mientras que los módulos de control requieren valores numéricos y acciones identificadas. Por ello se utiliza un parser, es decir, una función que reconoce los elementos de la instrucción y los transforma en una representación que puede ser utilizada por el programa.

El análisis se implementa en gcode_parser.c mediante gcode_parse_line(). Su resultado se almacena en una estructura GcodeCommand, que contiene el tipo de movimiento, los parámetros numéricos y banderas que indican cuáles estaban presentes en la línea.

Cada palabra se identifica mediante una letra y un valor numérico. Por ejemplo, en G1X12.5Y8F1200S300, la letra G identifica el movimiento, X e Y indican coordenadas, F establece el avance y S representa la consigna de accionamiento del láser. Las banderas permiten distinguir un parámetro omitido de uno cuyo valor es explícitamente cero.

El recorrido de la cadena admite letras mayúsculas o minúsculas y palabras consecutivas sin espacios. Se descartan los comentarios iniciados por punto y coma y se omiten los comentarios entre paréntesis en las líneas procesadas. Las líneas que comienzan, después de los espacios iniciales, con un comentario son descartadas.

La Figura 12 distingue recepción, análisis y ejecución. La conversión numérica se realiza mediante parse_gcode_number(), que reconoce un signo opcional, dígitos y una parte decimal opcional. Esta función evita interpretar la secuencia 0X10 de una instrucción G0X10 como un número hexadecimal. El comentario de implementación documenta que una conversión de propósito general podía consumir la X y su valor como parte del número, en lugar de reconocer una nueva palabra. El lector decimal corrige ese caso; no admite notación científica y no sustituye una validación sintáctica completa.

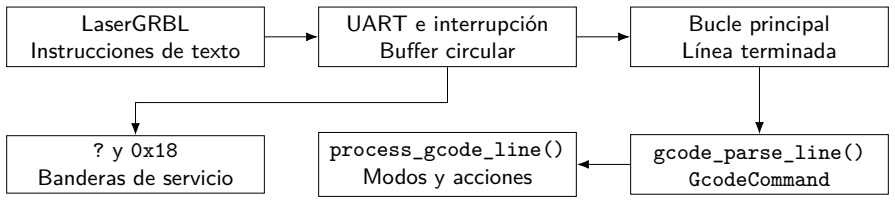
[picture p32: figure]
LaserGRBL Instrucciones de texto; UART e interrupción Buffer circular; Bucle principal Línea terminada; gcode_parse_line(); GcodeCommand; process_gcode_line() Modos y acciones; ? y 0x18 Banderas de servicio

Figura 12. Recorrido de las instrucciones. Los comandos de sistema se resuelven en main.c; los caracteres de servicio no ingresan al parser de líneas.

El parser no ejecuta movimientos ni modifica directamente las salidas. La estructura obtenida es entregada a process_gcode_line(), en main.c, donde se aplica el estado modal, se calculan los destinos y se invocan las operaciones correspondientes.

### 5.4. Comandos reconocidos y estado modal

La implementación reconoce un subconjunto de instrucciones, seleccionado para las funciones requeridas por el proyecto. Este conjunto se resume en la Tabla 5.

Tabla 5. Instrucciones y parámetros reconocidos por el firmware.

Instrucción | Función
G0 | Traslado con salida del láser anulada
G1 | Movimiento lineal con avance programado
G90, G91 | Coordenadas absolutas o relativas
G92, G92.1 | Establecer o borrar offsets X–Y
X, Y, Z | Consignas de posición
F | Avance expresado en mm/min
S | Consigna de accionamiento del láser
M3, M4 | Habilitación constante o dinámica
M5 | Deshabilitación del láser
M17, M84 | Habilitación o liberación de motores

Los comandos de sistema se atienden directamente en main.c. Entre ellos se encuentran $H, para solicitar la referenciación; $X, para limpiar la condición de alarma; $J=, para solicitar movimientos manuales; y $$, para consultar la configuración que el controlador informa al programa de computadora. LaserGRBL y GRBL son componentes distintos: el primero genera y envía instrucciones desde la computadora; en la NUCLEO se ejecuta el firmware propio [3].

El modo de coordenadas y el avance programado se conservan entre instrucciones. En los movimientos manuales introducidos mediante $J=, la selección de coordenadas absolutas o relativas se aplica a esa instrucción sin modificar el modo del programa.

Los offsets de trabajo permiten diferenciar las coordenadas utilizadas por el trabajo de las posiciones lógicas de máquina. En las consignas absolutas X–Y, los offsets se suman a las coordenadas recibidas para obtener el destino utilizado por el controlador.

Las instrucciones desconocidas detectadas por el parser se identifican mediante la bandera has_unknown. En ese caso se rechaza la línea completa y se transmite una respuesta de error. Este tratamiento no constituye una implementación completa del lenguaje G-code ni una validación exhaustiva de todas sus combinaciones. Los códigos G y M se convierten parcialmente a enteros y algunas secuencias mal formadas pueden ser aceptadas. Los comandos $H y $X requieren, además, el formato literal previsto por main.c.

### 5.5. Anticipación de segmentos mediante lookahead

Para reducir las detenciones entre segmentos consecutivos se implementa una anticipación de un segmento, denominada lookahead. Una consigna X–Y válida es almacenada en una estructura PendingMove, que conserva el destino, el avance, la dirección normalizada y la información asociada al láser.

Cuando se recibe el siguiente destino X–Y válido, se compara su dirección con la del segmento pendiente. La comparación se realiza mediante el producto escalar de ambos vectores normalizados:

c = dˆ

pendiente · dˆ
nuevo.

Si se cumple c > 0,999, los segmentos se consideran suficientemente alineados y con el mismo sentido. Esta condición es utilizada para solicitar que el segmento pendiente finalice a velocidad de crucero. En caso contrario, se solicita su desaceleración final.

El segmento pendiente es ejecutado mediante flush_pending_move(), y el nuevo segmento queda almacenado para la comparación posterior. Al calcular una nueva consigna relativa, se considera como referencia el destino del pendiente, de modo que las instrucciones mantienen su secuencia lógica.

Si no se recibe una continuación, el bucle principal ejecuta el pendiente al comprobar que transcurrieron más de 80 ms desde su almacenamiento. Esta condición es evaluada por software y no corresponde a una interrupción que se produzca exactamente al cumplirse dicho tiempo.

También se ejecuta el pendiente antes de determinadas operaciones que requieren conservar el orden, como un movimiento Z, M5, M84, un cambio de offsets o una actualización de S sin coordenadas X–Y.

La información del láser asociada al segmento es aplicada al comenzar su ejecución. De esta manera, la recepción de una consigna posterior no adelanta el valor S del nuevo segmento. El criterio de continuidad compara direcciones, pero no verifica igualdad de avances; un cambio de F entre segmentos alineados puede introducir una discontinuidad de velocidad.

Tabla 6. Ejemplo de orden de ejecución del lookahead; no representa una medición de tiempos.

Evento | Acción | Pendiente al finalizar
Llega segmento 1 | Se almacena; todavía no se mueve | Segmento 1
Llega segmento 2 | Se compara la dirección y se ejecuta 1 | Segmento 2
Llega segmento 3 | Se compara la dirección y se ejecuta 2 | Segmento 3
Sin continuación | Timeout mayor que 80 ms: se ejecuta 3 | Ninguno

La Tabla 6 muestra que el último segmento requiere una condición de vaciado. Su valor S se aplica al ejecutar ese segmento, no al recibir el siguiente.

Este mecanismo conserva un solo segmento pendiente y utiliza un criterio geométrico de continuidad. No constituye un planificador de múltiples bloques con optimización general de velocidades.

### 5.6. Alcance de la compatibilidad con LaserGRBL

El firmware implementa las funciones de comunicación y los comandos necesarios para el uso previsto con LaserGRBL. La consulta $$ informa los valores $30, $31 y $32, asociados al intervalo de S y a la identificación del modo láser.

La consigna máxima de S está configurada en 1000. Este valor debe ser coherente con la configuración utilizada al generar el trabajo. Las instrucciones M3 y M4 seleccionan accionamiento constante y dinámico, respectivamente; el comportamiento del PWM se desarrolla en la sección de control del láser.

La compatibilidad se limita a las funciones implementadas. La transmisión de un mensaje de bienvenida con formato GRBL no implica disponer de todas las instrucciones, configuraciones o mecanismos de planificación del firmware original. Por ello, el G-code utilizado debe verificarse respecto del conjunto admitido. Por ejemplo, G21, G2 y G3 no se reconocen en esta versión. El código conserva g_last_motion, pero no lo utiliza para determinar si una línea sin G explícita es rápida; por ello, no se garantiza la herencia completa de G0.

El reporte de estado utiliza Idle o Alarm, conserva Z y los campos de avance y accionamiento en cero, e informa los offsets X–Y mediante WCO. No constituye una medición del estado físico ni un reporte completo de GRBL.

### 6. Generación y coordinación del movimiento

### 6.1. Cinemática y elección del mecanismo CoreXY

El desplazamiento del cabezal en el plano X–Y se realiza mediante un mecanismo CoreXY. En esta arquitectura, dos motores fijos a la estructura actúan sobre una transmisión de correas que combina sus movimientos para producir los desplazamientos cartesianos del cabezal. Por lo tanto, ninguno de los motores corresponde exclusivamente al eje X o al eje Y.

Criterios de elección. La adopción de CoreXY estuvo vinculada con la utilización del diseño mecánico de referencia, cuya estructura y disposición de transmisión fueron conservadas. Esta elección permitió concentrar el desarrollo del proyecto en las interfaces eléctricas, la interpretación de instrucciones y la implementación del control de movimiento.

Desde el punto de vista funcional, la arquitectura resulta adecuada para el posicionamiento de un cabezal láser. A diferencia de una disposición cartesiana de ejes independientes en la que un eje transporta el motor del otro, CoreXY permite mantener ambos motores de accionamiento fijos al bastidor. De esta manera, se evita incorporar su masa a los conjuntos móviles, lo que favorece la capacidad de aceleración del mecanismo [5].

Esta característica es de interés para el grabado, donde se ejecutan desplazamientos sucesivos y cambios de sentido. Además, el procesamiento mediante láser no requiere transmitir las fuerzas de contacto propias de una herramienta de mecanizado, por lo que una transmisión por correas constituye una alternativa compatible con la aplicación prevista.

CoreXY conserva un espacio de trabajo descrito mediante coordenadas cartesianas. La diferencia respecto de los ejes accionados de manera independiente se encuentra en la relación entre esas coordenadas y los motores: en CoreXY debe realizarse una transformación para obtener las consignas de ambos actuadores.

Principio de funcionamiento. El acoplamiento se obtiene mediante el recorrido de las correas y su vinculación con el conjunto móvil. Con la convención adoptada, las contribuciones de los motores se suman para producir el desplazamiento en X y se restan para producir el desplazamiento en Y [6].

Puede interpretarse que un movimiento del motor A, manteniendo fijo el motor B, produce una combinación de desplazamientos en X e Y. La actuación del motor B aporta otra combinación que permite reforzar una componente y cancelar la otra. Así, la actuación coordinada de ambos motores permite obtener movimientos sobre los ejes cartesianos y trayectorias intermedias.

Para expresar esta relación se definen ∆a y ∆b como los desplazamientos lineales equivalentes de la transmisión asociados a los motores A y B. Estas magnitudes se expresan en unidades de longitud; su conversión a cantidades de pulsos se realiza posteriormente mediante la relación de transmisión configurada.

La transformación cinemática directa se expresa como:

∆x =

∆a + ∆b
2
, | ∆y = ∆a − ∆b
| 2
| . | (1)

En consecuencia, cuando ambos motores producen desplazamientos equivalentes de igual magnitud y signo, la componente en Y se anula y se obtiene un movimiento exclusivamente en X. Cuando sus desplazamientos tienen igual magnitud y signos opuestos, se anula la componente en X y se obtiene un movimiento exclusivamente en Y.

Transformación de las consignas. Las instrucciones G-code establecen destinos cartesianos, mientras que los actuadores requieren consignas de giro. Por ello, el firmware utiliza la transformación cinemática inversa para convertir cada desplazamiento solicitado en las actuaciones de los motores A y B:

∆a = ∆x + ∆y, | ∆b = ∆x − ∆y. | (2)

Estas relaciones también permiten interpretar los movimientos diagonales. Cuando ∆x = ∆y, el desplazamiento correspondiente al motor B es nulo. Cuando ∆x = −∆y, es nula la actuación del motor A.

Los signos dependen de la disposición de las correas, de la identificación de los motores y de la conexión de sus bobinas. Por ello, la convención del programa debe comprobarse mediante movimientos de prueba sobre cada eje.

La transformación determina la cantidad de movimiento requerida en cada actuador, pero no establece por sí sola su evolución temporal. Para conservar una trayectoria rectilínea, el firmware debe distribuir los pulsos de ambos motores de manera coordinada, manteniendo la proporción correspondiente al segmento solicitado. Esta tarea es realizada por el algoritmo de generación de pasos descrito en los apartados siguientes.

Ventajas y limitaciones. La principal ventaja de la arquitectura para esta aplicación es la reducción de masa móvil obtenida al mantener los motores sobre el bastidor. A ello se suma una transformación cinemática lineal, basada en sumas y restas, cuya implementación requiere un procesamiento reducido.

Como contrapartida, la transmisión presenta un recorrido de correas y una disposición de poleas más complejos que los de dos ejes accionados de forma independiente. El montaje requiere controlar la alineación de los elementos, la escuadra del mecanismo y la tensión de las correas. Un ajuste inadecuado puede aumentar el rozamiento, favorecer deformaciones o afectar el desplazamiento del cabezal [10].

El acoplamiento también implica que un error de actuación de uno de los motores puede afectar simultáneamente a las dos coordenadas cartesianas. Por otra parte, la elasticidad de las correas y la rigidez del conjunto limitan la correspondencia entre el movimiento comandado y el obtenido.

Por estas razones, la elección de CoreXY se justifica por su adecuación al cabezal y a las trayectorias previstas, junto con la disponibilidad del diseño mecánico adoptado. No se considera una garantía de mayor exactitud: las prestaciones alcanzadas deben comprobarse mediante ensayos sobre la máquina construida.

### 6.2. Conversión de desplazamientos en pulsos

La generación del movimiento requiere expresar las consignas de los motores como cantidades enteras de pulsos. Para ello se utiliza un factor de conversión Ks, expresado en pulsos por milímetro, que depende del ángulo de paso del motor, la subdivisión de pasos seleccionada en el driver y las características de la transmisión.

Para una polea dentada, el factor se calcula mediante:

Ks =

Nrev m
z p
, | (3)

donde Nrev es la cantidad de pasos completos por revolución, m es el factor de subdivisión de pasos, z es la cantidad de dientes de la polea y p es el paso de la correa.

En la configuración del firmware se consideran motores de 1,8

- por paso, equivalentes a 200 pasos completos por revolución, subdivisión de 1/16 de paso y poleas de 20 dientes con correas de paso de 2 mm. Con estos parámetros se obtiene:

Ks =

200 × 16
20 × 2
| = 80 pulsos/mm. | (4)

Este valor corresponde a los parámetros configurados en el programa y debe ser contrastado con los componentes y los ajustes utilizados en el montaje.

A partir del desplazamiento solicitado, las cantidades de pulsos con signo se determinan como:

NA = round [Ks(∆x + ∆y)] , | NB = round [Ks(∆x − ∆y)] . | (5)

La operación de redondeo permite obtener valores enteros compatibles con el accionamiento discreto de los motores. El signo de cada resultado establece el sentido de giro mediante la señal DIR, mientras que su valor absoluto determina la cantidad de pulsos que debe generarse en STEP.

En el módulo stepper, estas operaciones se realizan a partir de la diferencia entre el destino solicitado y la posición lógica conservada por el firmware. La configuración permite, además, invertir el sentido de X en la transformación cinemática para adecuarlo al montaje.

### 6.3. Interpolación y sincronización de los motores

La transformación cinemática determina las cantidades totales de pulsos necesarias para alcanzar el destino. Sin embargo, estas cantidades no definen por sí solas la trayectoria seguida durante el desplazamiento. También debe establecerse cómo se distribuyen los pulsos de ambos motores a lo largo del segmento.

Si todos los pasos de un motor fueran ejecutados antes que los del otro, podría alcanzarse el mismo destino ideal mediante una trayectoria diferente de la recta solicitada. Por ello, los accionamientos deben coordinarse durante la ejecución.

En el proyecto se utiliza una interpolación discreta basada en el algoritmo de Bresenham. Se identifica como accionamiento principal al motor que requiere la mayor cantidad de pulsos:

Nmayor = m´ax(|NA|, |NB|), | Nmenor = m´ın(|NA|, |NB|). | (6)

En cada evento de temporización se genera un pulso para el motor principal. La generación del pulso del motor secundario se decide mediante un acumulador de error, que permite distribuir sus pasos proporcionalmente durante el recorrido.

El acumulador se inicializa con la mitad entera de Nmayor. En cada evento se resta Nmenor; cuando el resultado es negativo, se genera también un pulso para el motor secundario y se suma Nmayor al acumulador. De esta manera se conserva la proporción requerida sin efectuar una división en cada decisión de paso.

Por ejemplo, para un desplazamiento de ∆x = 10 mm y ∆y = 5 mm, con el factor configurado de 80 pulsos/mm, se obtiene:

NA = 1200, | NB = 400. | (7)

El motor A constituye el accionamiento principal y recibe un pulso en cada evento. Los 400 pulsos del motor B se distribuyen durante el segmento, aproximadamente uno cada tres eventos. La relación entre ambos accionamientos permite aproximar la trayectoria rectilínea mediante movimientos discretos.

Para visualizar la distribución sin una secuencia de 1200 eventos, la Tabla 7 utiliza Nmayor = 12 y Nmenor = 4, con la misma proporción 3:1 del ejemplo. El error inicial es 6; la condición es estrictamente negativa.

Tabla 7. Secuencia ilustrativa de Bresenham calculada con la regla del firmware. Un 1 indica un pulso.

Evento | 1 | 2 | 3 | 4 | 5 | 6 | 7 | 8 | 9 | 10 | 11 | 12
Principal | 1 | 1 | 1 | 1 | 1 | 1 | 1 | 1 | 1 | 1 | 1 | 1
Secundario | 0 | 1 | 0 | 0 | 1 | 0 | 0 | 1 | 0 | 0 | 1 | 0

Cuando ambos motores requieren igual cantidad de pulsos, se acciona cada uno en todos los eventos. Cuando uno de ellos no requiere desplazamiento, solo se generan pulsos para el otro.

La coordinación se realiza desde una misma rutina de interrupción de TIM2. De esta manera, las decisiones de paso de ambos motores comparten una referencia temporal y un contador de avance del segmento.
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
