Nicoop/CNC_Laser_micro/Documentation/respaldo-revision-final-2026-10-16/main.pdf

Facultad de Ingeniería - UNCuyo | Mendoza, Argentina

INFORME DE PROYECTO

# Diseño e implementación de una CNC láser controlada mediante una placa NUCLEO-F446RE

Nicolas Patricelli¹

Federico Barrios Retta²

1Facultad de Ingeniería, Universidad Nacional de Cuyo, Argentina 2Facultad de Ingeniería, Universidad Nacional de Cuyo, Argentina

Resumen

Se presenta el desarrollo de un controlador para una CNC de grabado y corte láser, basado en una placa NUCLEO-F446RE. Se describen la estructura mecánica adoptada, las interfaces eléctricas y el firmware modular en C. Las instrucciones generadas con LaserGRBL se reciben por UART, se interpretan y se convierten en consignas para el mecanismo CoreXY y el eje Z. La coordinación de los motores utiliza interpolación discreta y temporizadores, mientras que el accionamiento del láser se comanda mediante PWM. El documento corresponde a un avance del proyecto; la caracterización
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
