Nicoop/CNC_Laser_micro/Documentation/attachments/4601d693cab7aa5bb9f065cb70102b46.webp

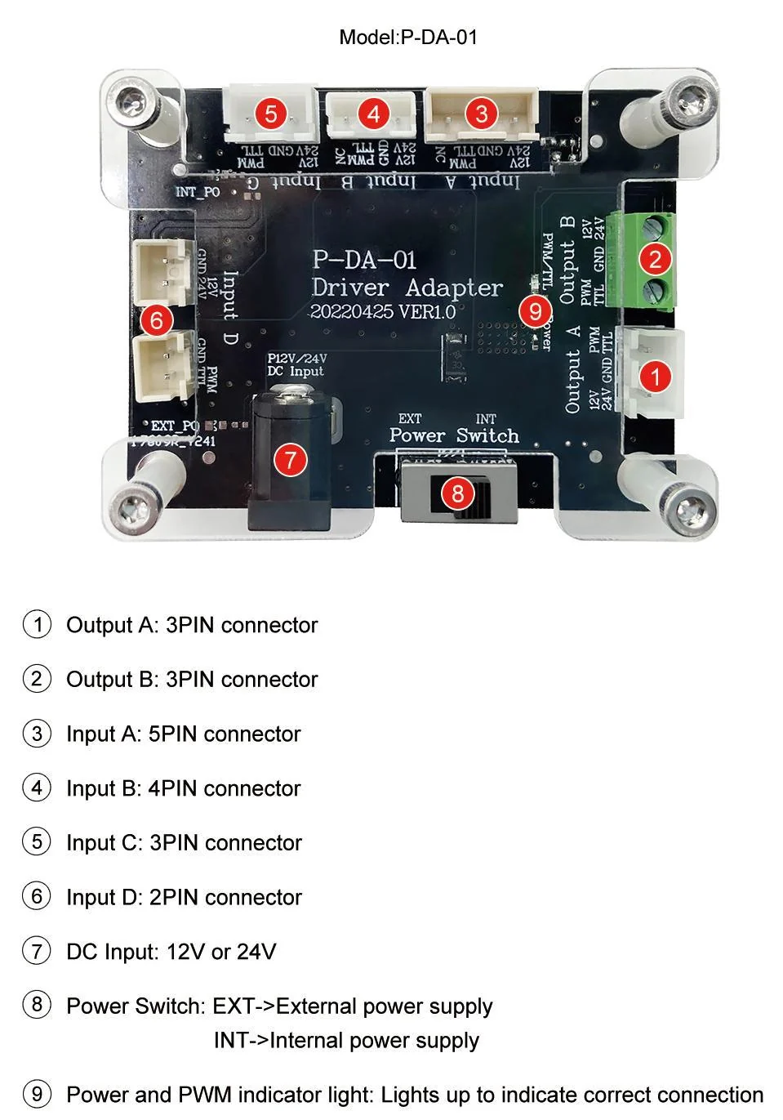
Documentation/attachments/4601d693cab7aa5bb9f065cb70102b46.webp
