Nicoop/CNC_Laser_micro/Documentation/attachments/Alarmas - Maquina de Estado.png

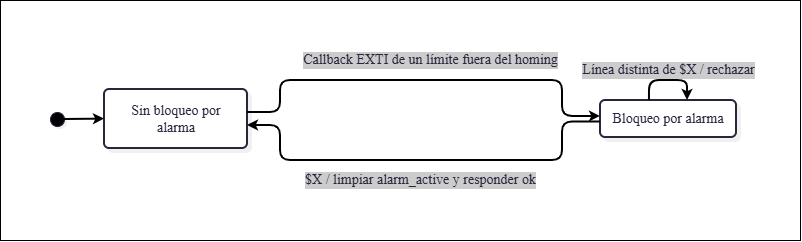
Documentation/attachments/Alarmas - Maquina de Estado.png
