Nicoop/CNC_Laser_micro/Documentation/attachments/Ejecucion - Maquina de Estados.png

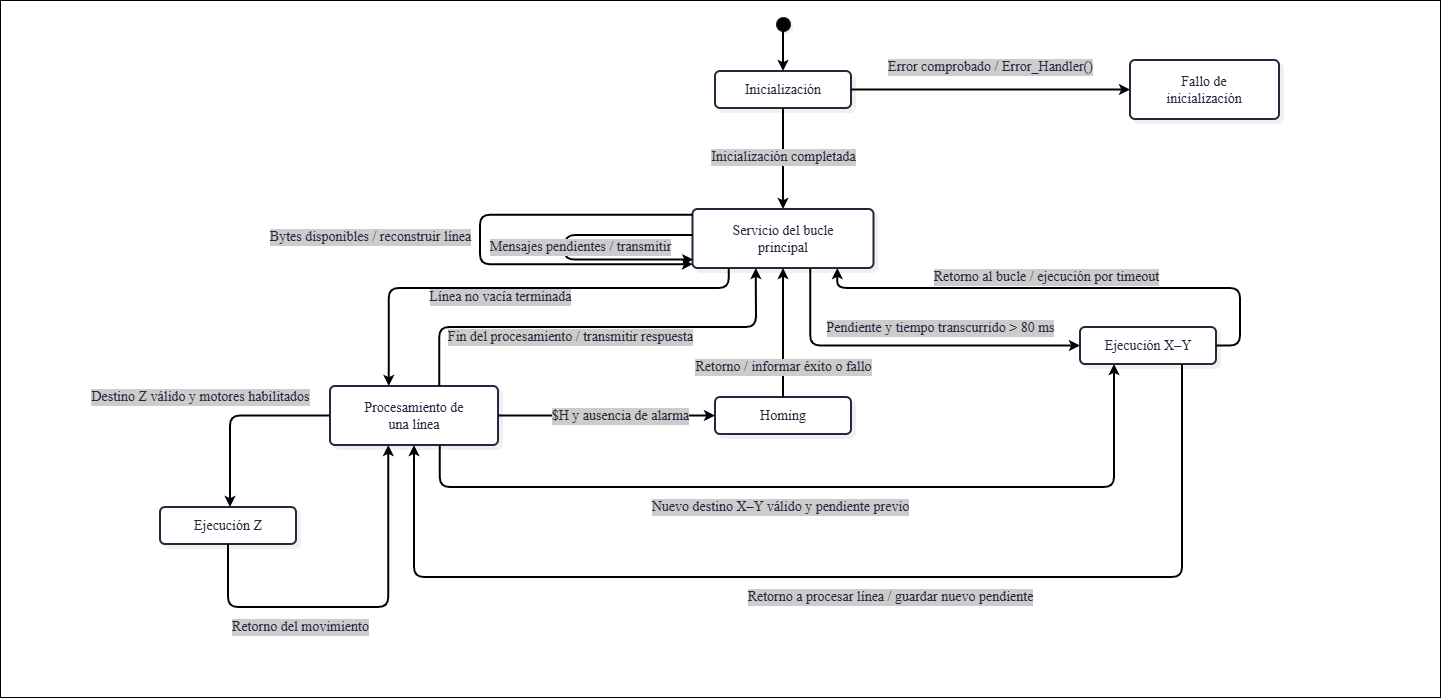
Documentation/attachments/Ejecucion - Maquina de Estados.png
