Nicoop/CNC_Laser_micro/Documentation/attachments/Infografía del módulo láser LT-40W-F23.png

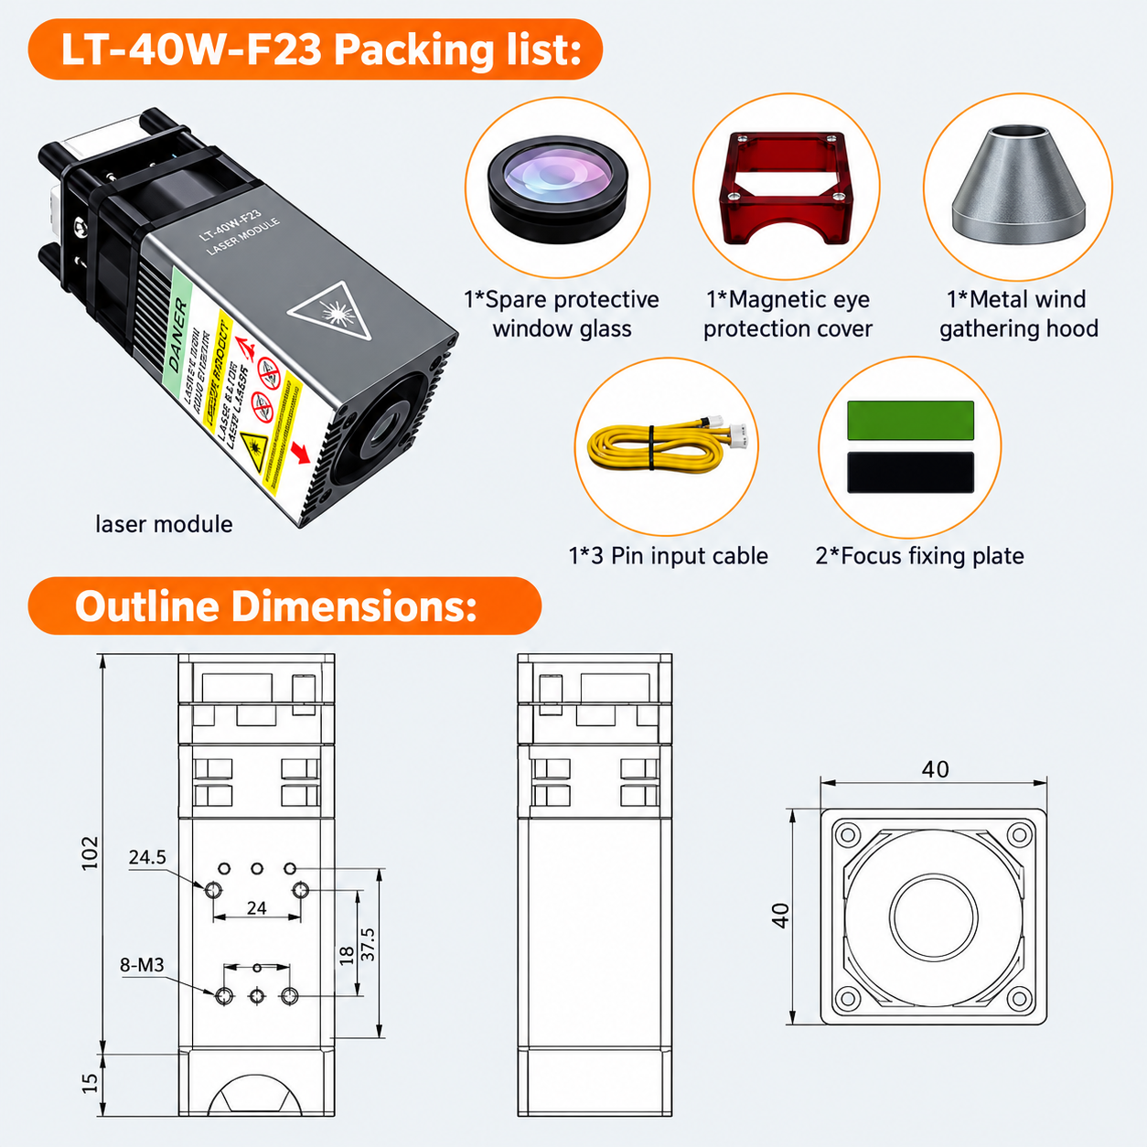
Documentation/attachments/Infografía del módulo láser LT-40W-F23.png
