Nicoop/CNC_Laser_micro/Documentation/attachments/laser.jpg

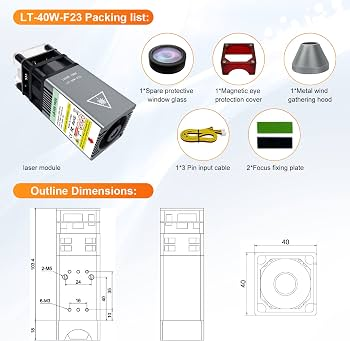
Documentation/attachments/laser.jpg
