Nicoop/CNC_Laser_micro/Documentation/attachments/Maquina de Estados - Flujos de Accion.png

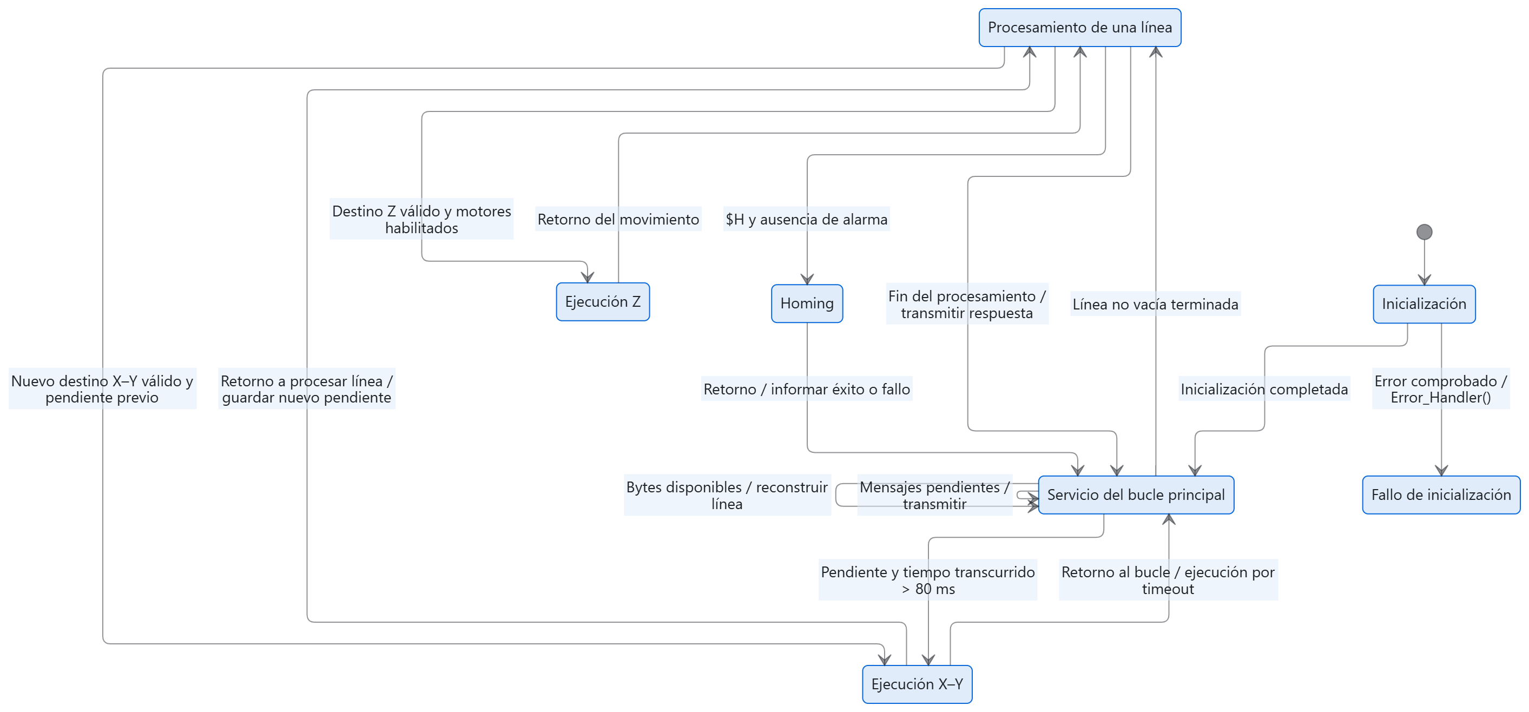
Documentation/attachments/Maquina de Estados - Flujos de Accion.png
