Nicoop/CNC_Laser_micro/Documentation/attachments/Maquina de Estados.jpg

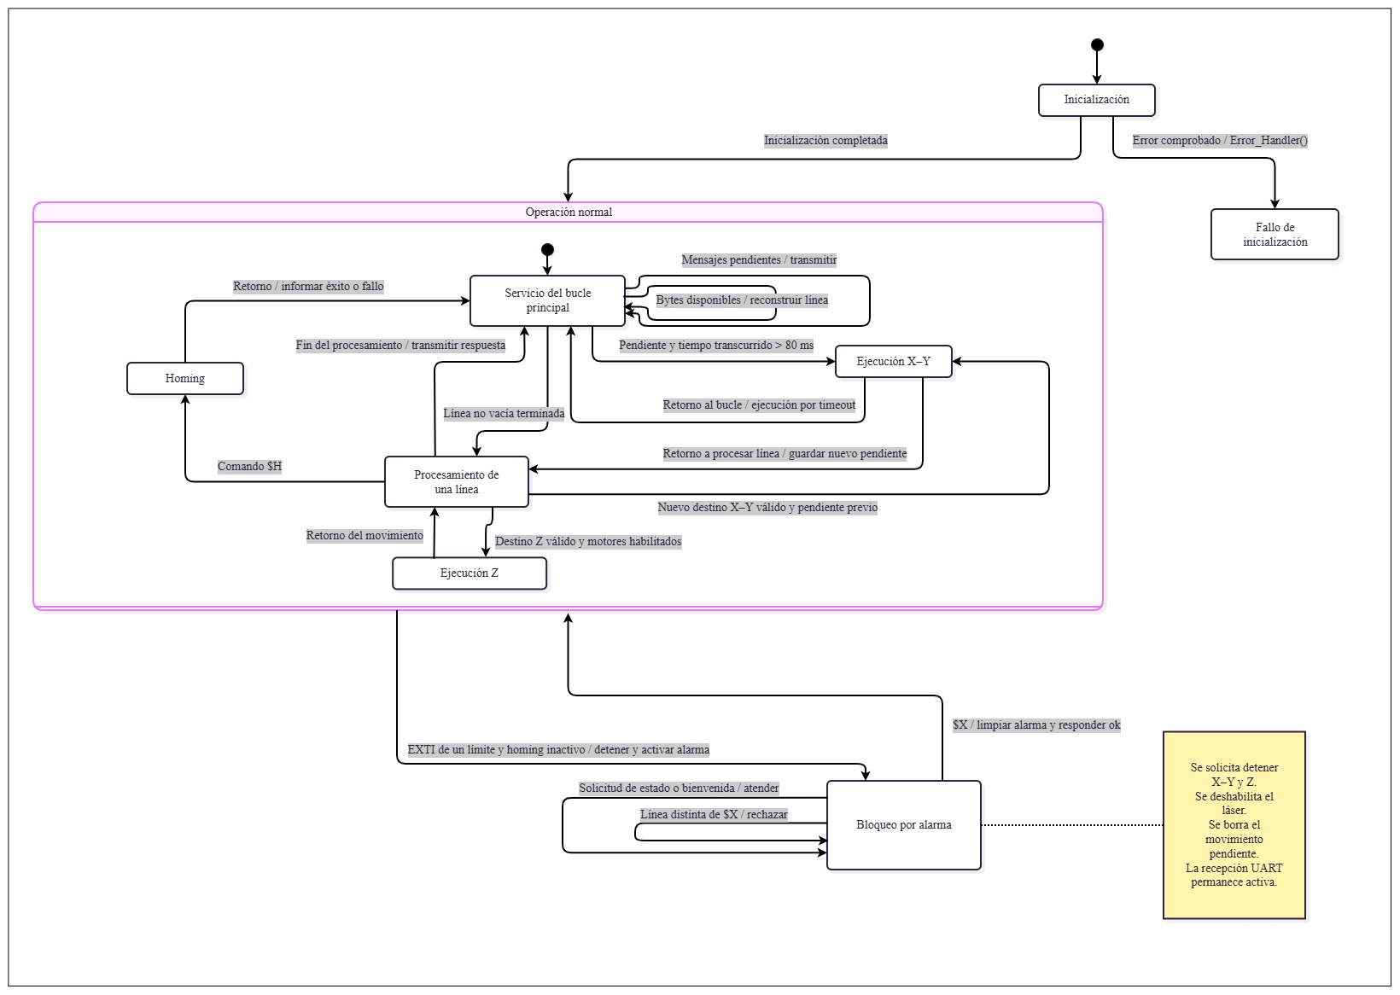
Documentation/attachments/Maquina de Estados.jpg
