Nicoop/CNC_Laser_micro/Documentation/attachments/Esquematico - Blanco y Negro.pdf

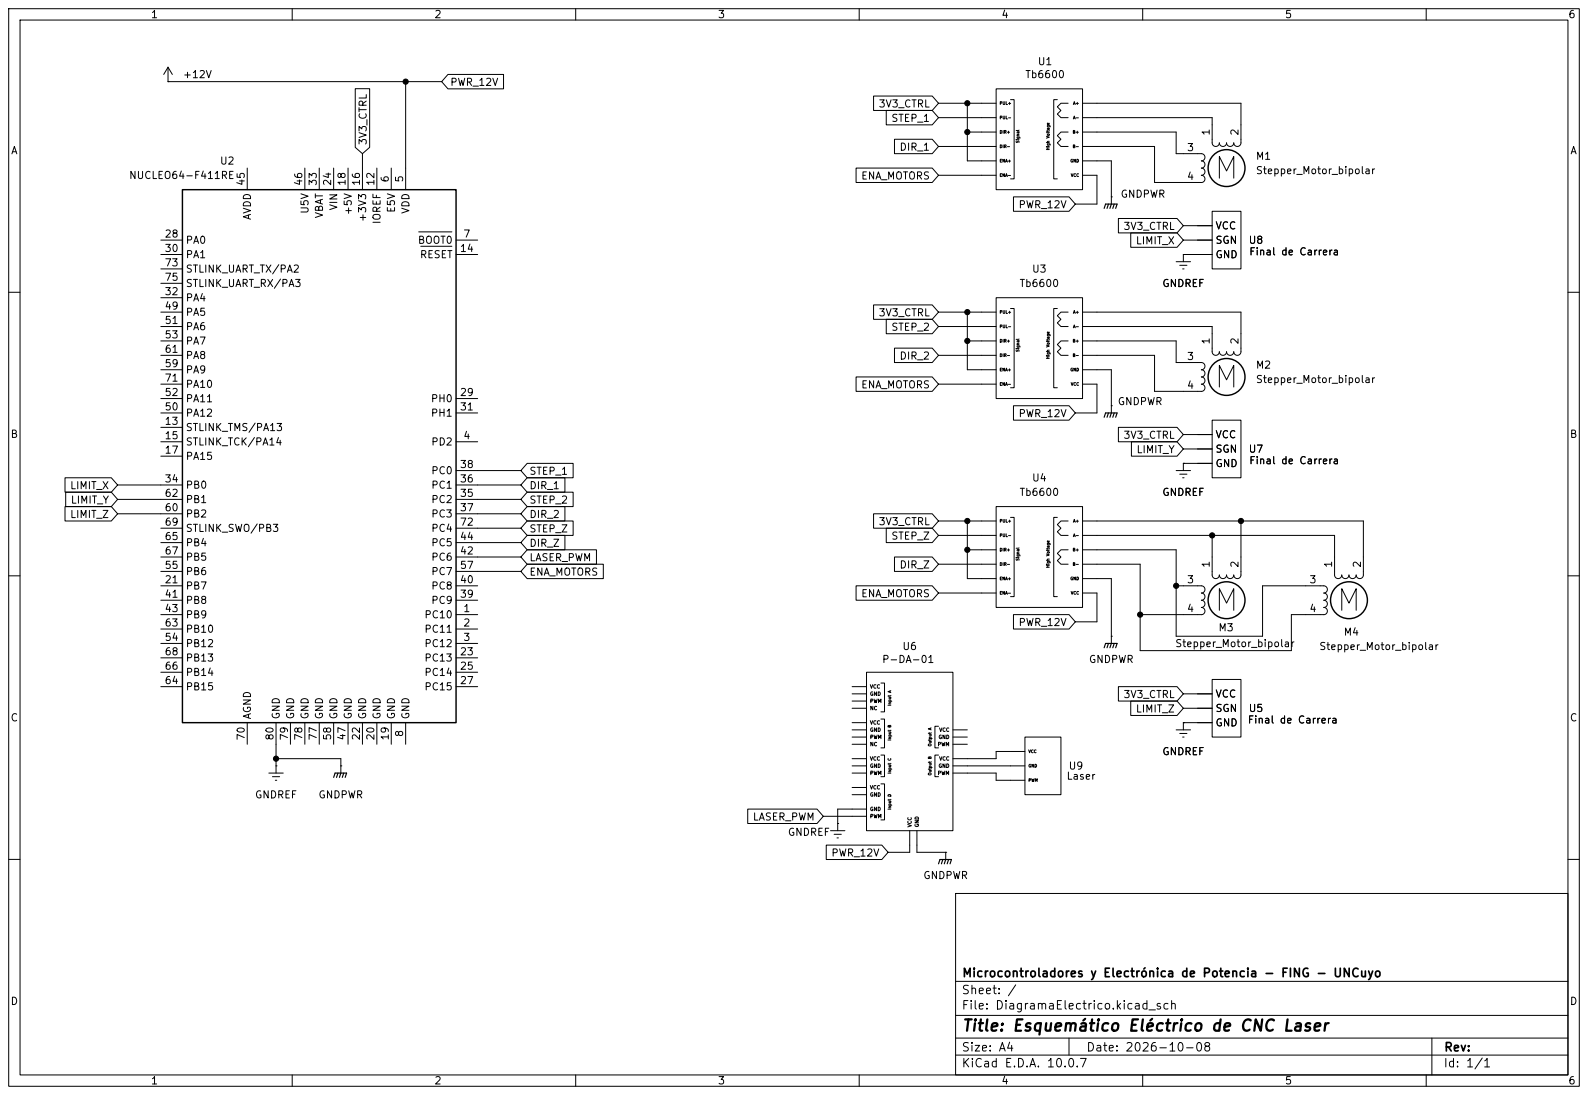
[picture p40: page 1]

Final de Carrera GNDPWR

Sheet: /
File: DiagramaElectrico.kicad_sch
Title: Esquemático Eléctrico de CNC Laser

Size: A4 | Rev:
KiCad E.D.A. 10.0.7 | Id: 1/1
