Nicoop/CNC_Laser_micro/Documentation/DiagramaElectrico/DiagramaElectrico.kicad_sch

## KiCad design Documentation/DiagramaElectrico/DiagramaElectrico.kicad_sch (2026-10-23, an earlier design)

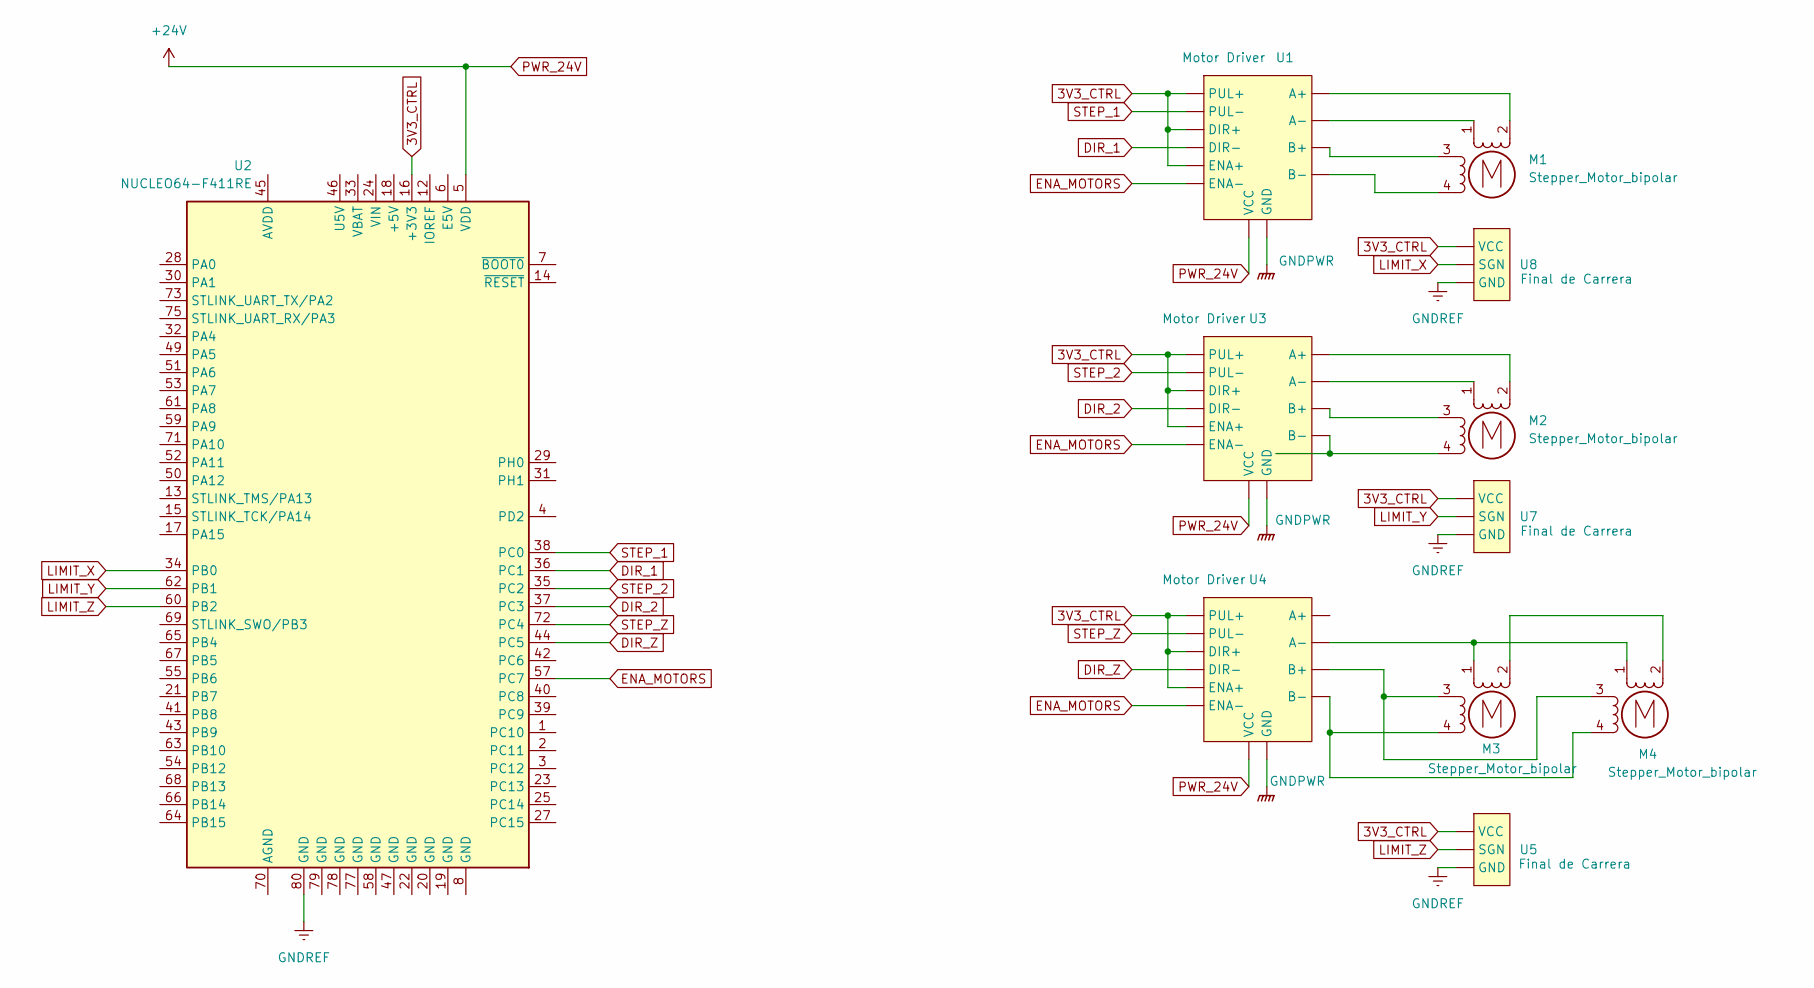
[picture p41: schematic DiagramaElectrico.kicad_sch]

Parts:
M1, M2, M3, M4: Stepper_Motor_bipolar
U1, U3, U4: Motor Driver
U2: NUCLEO64-F411RE; ST_Morpho_Connector_144_STLink
U5, U7, U8: Final de Carrera

Connections:
3V3_CTRL: U1., U2.16 (+3V3), U3., U4., U5., U7., U8.
+24V: U1., U2.5 (VDD), U3., U4.
DIR_1: U1., U2.36 (PC1)
DIR_2: U2.37 (PC3), U3.
DIR_Z: U2.44 (PC5), U4.
ENA_MOTORS: U1., U2.57 (PC7), U3., U4.
GNDPWR: U1., U3., U4.
GNDREF: U2.80 (GND), U5., U7., U8.
LIMIT_X: U2.34 (PB0), U8.
LIMIT_Y: U2.62 (PB1), U7.
LIMIT_Z: U2.60 (PB2), U5.
unnamed: M1.1, U1.
unnamed: M1.2 (-), U1.
unnamed: M1.3, U1.
unnamed: M1.4, U1.
unnamed: M2.1, U3.
unnamed: M2.2 (-), U3.
unnamed: M2.3, U3.
unnamed: M2.4, U3.
unnamed: M3.1, M4.1, U4.
unnamed: M3.2 (-), M4.2 (-)
unnamed: M3.3, M4.3, U4.
unnamed: M3.4, M4.4, U4.
STEP_1: U1., U2.38 (PC0)
STEP_2: U2.35 (PC2), U3.
STEP_Z: U2.72 (PC4), U4.
