Nicoop/CNC_Laser_micro/Core/Src/main.c

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
/* Includes ------------------------------------------------------------------*/
#include "main.h"

/* USER CODE BEGIN Includes */
/* todos mis modulos propios. cada uno maneja una parte de la maquina
 * por separado (motores x/y, eje z, laser, enable de motores, homing,
 * parser de gcode), asi el main.c queda mas que nada como el que
 * conecta todo y maneja la comunicacion */
#include "corexy_config.h"
#include "homing.h"
#include "motor_enable.h"
#include "watchdog.h"
#include "z_axis.h"
#include "laser.h"
#include "gcode_parser.h"
#include "stepper.h"
#include <stdio.h>
#include <math.h>
#include <string.h>
/* USER CODE END Includes */

IWDG_HandleTypeDef hiwdg;

TIM_HandleTypeDef htim2;
TIM_HandleTypeDef htim3;
TIM_HandleTypeDef htim4;

UART_HandleTypeDef huart2;

/* USER CODE BEGIN PV */

/* ===== mensajes hacia laser grbl =====
 * laser grbl solo muestra lineas en formato grbl: "ALARM:n", "error:n" y
 * "[MSG:texto]". cualquier otro texto lo ignora (se ve en blanco).
 * regla: una linea de gcode recibe UNA sola respuesta, "ok" o "error:n".
 * por eso los avisos que no cortan el flujo van como [MSG:...] y despues
 * sale el "ok" normal, asi no se desincroniza el conteo de laser grbl.
 * todos los textos estan juntos aca para cambiarlos facil. */
#define MSG_WELCOME          "\r\nGrbl 1.1h ['$' for help]\r\n"
#define MSG_OK               "ok\r\n"
#define MSG_ALARM_LIMIT_FMT  "ALARM:1\r\n[MSG:Final de carrera %c]\r\n[MSG:Motores libres. $X y M17]\r\n"
#define MSG_WARN_FEED_FMT    "[MSG:F%d supera max. Uso F%d]\r\n"
#define MSG_ALARM_ESTOP      "ALARM:3\r\n[MSG:Parada de emergencia]\r\n[MSG:Motores libres. Rearme, $X y $H]\r\n"
#define MSG_ERR_ESTOP_HELD   "error:9\r\n[MSG:Emergencia apretada. Rearme]\r\n"
#define MSG_ALARM_WATCHDOG   "ALARM:3\r\n[MSG:Reinicio por watchdog]\r\n[MSG:Posicion perdida. $X y $H]\r\n"
#define MSG_ALARM_HOMING     "ALARM:9\r\n[MSG:Homing fallo]\r\n"
#define MSG_ERR_UNKNOWN      "error:20\r\n[MSG:Comando no reconocido]\r\n"
#define MSG_ERR_UNKNOWN_SYS  "error:3\r\n[MSG:Comando $ no reconocido]\r\n"
#define MSG_ERR_LOCKED       "error:9\r\n[MSG:En alarma. Mande $X]\r\n"
#define MSG_WARN_MOTORS_OFF  "[MSG:Motores off. Mande M17]\r\n"
#define MSG_WARN_OUT_XY      "[MSG:Fuera de area XY]\r\n"
#define MSG_WARN_OUT_Z       "[MSG:Fuera de area Z]\r\n"


/* bandera de alarma: se activa cuando un final de carrera se dispara
 * de improviso en medio de un movimiento normal (no durante el homing
 * a proposito). mientras esta activa, el firmware rechaza cualquier
 * comando nuevo hasta que se mande $X a mano. asi me aseguro de que si
 * la maquina choco contra algo, no siga como si nada mientras laser
 * grbl le sigue mandando lineas del trabajo */
static volatile bool alarm_active = false;

/* offset de trabajo (G92). posicion de trabajo = posicion de maquina -
 * offset. la posicion de maquina (la del homing, 0..240 / 0..200) nunca
 * se toca, asi siempre se conserva la referencia fisica y los limites
 * del area se controlan contra la maquina real */
static float g_off_x = 0.0f;
static float g_off_y = 0.0f;
/* esta otra bandera es para que el mensaje de alarma se mande una sola
 * vez (desde el main, nunca desde la interrupcion) aunque el switch
 * rebote mecanicamente y dispare la interrupcion varias veces por una
 * sola pulsada real */
static volatile bool alarm_message_pending = false;

/* ---- parada de emergencia (pulsador) ----
 * el pulsador va a PB4 (EXTI4). se cablea NORMALMENTE CERRADO entre PB4 y
 * GND, con el pull-up interno: en reposo el contacto lo mantiene en BAJO,
 * al apretar (o si se corta un cable) el contacto se abre y el pull-up lo
 * sube a ALTO. asi una falla del cableado tambien dispara la emergencia
 * (a prueba de fallas). si prefieren un NA a GND, cambiar
 * ESTOP_PRESSED_LEVEL a GPIO_PIN_RESET y el flanco a FALLING en el .ioc */
#ifndef ESTOP_Pin
#define ESTOP_Pin        GPIO_PIN_4
#define ESTOP_GPIO_Port  GPIOB
#endif
#define ESTOP_PRESSED_LEVEL  GPIO_PIN_SET
#define ESTOP_DEBOUNCE_US    1000U

/* la isr la carga y el main la lee para mandar el mensaje una sola vez */
static volatile bool estop_message_pending = false;
/* true desde que se aprieta hasta que se manda $X con el pulsador liberado */
static volatile bool estop_latched = false;

static inline bool estop_pressed(void)
{
    return HAL_GPIO_ReadPin(ESTOP_GPIO_Port, ESTOP_Pin) == ESTOP_PRESSED_LEVEL;
}
/* cual final de carrera disparo la alarma: 'X', 'Y' o 'Z' (lo carga la isr, lo imprime el main) */
static volatile char alarm_limit_axis = '?';

/* esto es el "look ahead" simplificado: en vez de ejecutar cada linea
 * de gcode apenas llega, guardo el movimiento pendiente y espero a ver
 * la linea siguiente antes de decidir si freno al final o no. si el
 * siguiente movimiento sigue exactamente la misma direccion (mismo
 * signo de avance en x e y), no hace falta frenar entre uno y otro -
 * eso es lo que evita que el laser se quede pegado quemando de mas en
 * cada microsegmento del raster */
typedef struct {
    bool valid;
    float target_x, target_y, feed;
    float dir_x, dir_y;
    bool is_rapid;        /* true = era un G0, apagar el láser al ejecutar */
    bool has_laser_s;     /* true = esta línea traía S */
    float laser_s;        /* el valor de S a aplicar justo al ejecutar */
} PendingMove;
static PendingMove g_pending = {0};
static uint32_t g_last_line_tick = 0;
/* si no llega una linea nueva en este tiempo, asumo que no hay
 * continuacion y ejecuto el movimiento pendiente frenando normal (por
 * ejemplo, si justo esa era la ultima linea del archivo) */
#define LOOKAHEAD_TIMEOUT_MS 80

/* banderas para mandar mensajes desde el main en vez de desde las
 * interrupciones. esto es clave: si se manda un HAL_UART_Transmit()
 * directo desde una isr, puede chocar con una transmision que ya este
 * en curso desde el main, y el uart queda trabado para siempre. por
 * eso la isr SOLO prende una bandera, y el unico que transmite de
 * verdad es el main() */
static volatile uint8_t welcome_pending = 0;
static volatile uint8_t status_report_pending = 0;

/* buffer circular para los bytes que van llegando por uart. hace falta
 * porque mientras un movimiento esta en curso (stepper_move_to es
 * bloqueante) el main no puede ir leyendo el uart activamente, pero la
 * interrupcion de recepcion si sigue funcionando y puede ir guardando
 * los bytes nuevos aca hasta que el main este libre para procesarlos */
#define RX_RING_SIZE 256
static volatile uint8_t  rx_ring[RX_RING_SIZE];
static volatile uint16_t rx_ring_head = 0;
static volatile uint16_t rx_ring_tail = 0;

#define GCODE_LINE_BUF_SIZE 96
static uint8_t g_absolute_mode = 1; /* 1 = G90 (absoluto, por defecto en Grbl), 0 = G91 (relativo) */
static GcodeCommandType g_last_motion = GCODE_G1;
static float g_last_feed_mm_min = 0.0f; /* el f es modal: si una linea no lo trae, se sigue usando el ultimo que llego */
static uint8_t  rx_byte;
static char     line_buf[GCODE_LINE_BUF_SIZE];
static uint16_t line_idx = 0;
static volatile uint8_t line_ready = 0; /* esta ya no se usa para nada (quedo de una version vieja), pero no molesta */
/* USER CODE END PV */

void SystemClock_Config(void);
static void MX_GPIO_Init(void);
static void MX_USART2_UART_Init(void);
static void MX_TIM2_Init(void);
static void MX_TIM3_Init(void);
static void MX_TIM4_Init(void);
static void MX_IWDG_Init(void);
/* USER CODE BEGIN PFP */
static void flush_pending_move(bool exit_at_cruise);
static void send_status_report(UART_HandleTypeDef *huart);
static void process_gcode_line(char *raw_line);
static void service_realtime(void);
static void uart_tx(UART_HandleTypeDef *h, uint8_t *p, uint16_t n, uint32_t to);
/* USER CODE END PFP */

/**
  * @brief  The application entry point.
  * @retval int
  */
int main(void)
{

  /* MCU Configuration--------------------------------------------------------*/

  /* Reset of all peripherals, Initializes the Flash interface and the Systick. */
  HAL_Init();

  /* USER CODE BEGIN Init */
  /* con el debugger frenado en un breakpoint, congelo el watchdog para que no reinicie la placa */
  __HAL_DBGMCU_FREEZE_IWDG();

  /* USER CODE END Init */

  /* Configure the system clock */
  SystemClock_Config();

  /* Initialize all configured peripherals */
  MX_GPIO_Init();
  MX_USART2_UART_Init();
  MX_TIM2_Init();
  MX_TIM3_Init();
  MX_TIM4_Init();
  MX_IWDG_Init();
  /* USER CODE BEGIN 2 */

  /* inicializo todos mis modulos. el orden ac no importa mucho entre
   * ellos, lo que si importa es que esto pase despues de que el cubemx
   * ya configuro los gpio y los timers arriba */
  homing_init();
  motor_enable_init();
  z_axis_init(&htim4);
  stepper_init(&htim2);
  laser_init(&htim3, TIM_CHANNEL_1);
  HAL_UART_Receive_IT(&huart2, &rx_byte, 1); /* arranco la recepcion por interrupcion, un byte a la vez */

  /* mando el mensaje de bienvenida tipo grbl apenas arranca, para el
   * caso de que algun programa ya este escuchando el puerto desde antes
   * de que yo conecte el cable */
  /* watchdog: lo configura y arranca cubemx (MX_IWDG_Init). aca solo miro
   * si el reinicio anterior fue por watchdog. si el firmware se cuelga mas
   * de ~2 s sin llamar a watchdog_refresh(), la placa se reinicia sola */
  bool reset_por_watchdog = watchdog_caused_last_reset();

  const char *welcome = MSG_WELCOME;
  uart_tx(&huart2, (uint8_t*)welcome, strlen(welcome), 100);
  if (reset_por_watchdog) {
      /* se perdio la posicion: dejo la maquina bloqueada hasta $X y $H */
      alarm_active = true;
      uart_tx(&huart2, (uint8_t*)MSG_ALARM_WATCHDOG, strlen(MSG_ALARM_WATCHDOG), 100);
  }
  if (estop_pressed()) {
      /* si prenden la placa con la emergencia apretada, arranca en alarma */
      estop_latched = true;
      alarm_active = true;
      motors_disable();
      uart_tx(&huart2, (uint8_t*)MSG_ALARM_ESTOP, strlen(MSG_ALARM_ESTOP), 100);
  }
  stepper_init(&htim2); /* esto quedo duplicado de una version anterior, no hace falta pero tampoco molesta */
  HAL_UART_Receive_IT(&huart2, &rx_byte, 1);

  /* le digo al stepper que, mientras espera a que termine un movimiento
   * largo, llame a service_realtime(). asi se siguen contestando el '?'
   * y los avisos y laser grbl no cree que la placa se colgo. va despues
   * de los stepper_init por si alguno de ellos reinicia el estado */
  stepper_set_wait_callback(service_realtime);
  /* USER CODE END 2 */

  /* Infinite loop */
  /* USER CODE BEGIN WHILE */
  while (1)
  {
	  /* atiendo los mensajes pendientes (alarma, bienvenida, estado)
	   * ANTES que nada mas, asi salen apenas se puede */
	  service_realtime();

      /* si quedo un movimiento pendiente esperando a ver si la proxima
       * linea continua en la misma direccion, y paso demasiado tiempo
       * sin que llegue nada nuevo, lo ejecuto igual frenando normal.
       * esto es importante para que no se quede "trabado" esperando
       * para siempre el ultimo segmento de un trabajo */
      if (g_pending.valid && (HAL_GetTick() - g_last_line_tick > LOOKAHEAD_TIMEOUT_MS)) {
          flush_pending_move(false); /* frena normal, no llegó continuación */
      }

      /* vacio el buffer circular armando lineas completas de texto.
       * cuando encuentro un \n o \r, ahi se termino una linea y la
       * mando a procesar */
      while (rx_ring_tail != rx_ring_head) {
          uint8_t b = rx_ring[rx_ring_tail];
          rx_ring_tail = (rx_ring_tail + 1) % RX_RING_SIZE;

          if (b == '\n' || b == '\r') {
              if (line_idx > 0) {
                  line_buf[line_idx] = '\0';
                  process_gcode_line(line_buf);
                  line_idx = 0;
                  service_realtime();
              }
          } else if (line_idx < GCODE_LINE_BUF_SIZE - 1) {
              line_buf[line_idx++] = (char)b;
          }
      }
    /* USER CODE END WHILE */

    /* USER CODE BEGIN 3 */
    }
  /* USER CODE END 3 */
}

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
/* USER CODE BEGIN 4 */

/* convierte un float a texto con 3 decimales fijos, sin usar printf con
 * %f (que en este toolchain embebido no siempre anda bien con floats
 * sin configuracion extra, asi que lo hago a mano con enteros) */
static void format_float3(float value, char *out, size_t out_size)
{
    int sign = (value < 0.0f) ? -1 : 1;
    float absval = value * sign;
    int32_t scaled = (int32_t)lroundf(absval * 1000.0f);
    int32_t whole = scaled / 1000;
    int32_t frac  = scaled % 1000;
    snprintf(out, out_size, "%s%ld.%03ld", (sign < 0) ? "-" : "", (long)whole, (long)frac);
}

/* arma y manda el reporte de estado que laser grbl pide con el
 * caracter '?'. el formato "<Idle|MPos:x,y,z|FS:f,s>" es el que usa
 * grbl de verdad, lo imito para que laser grbl lo entienda y pueda
 * mostrar la posicion actual en su interfaz. por ahora mando z fijo en
 * 0.000 porque no lo estoy reportando todavia (se podria agregar
 * despues si hace falta) */
static void send_status_report(UART_HandleTypeDef *huart)
{
    /* si todavia hay un tx en curso, lo dejo para la proxima vuelta. esto va
     * ANTES de armar el texto: msg es static y el tx anterior lo sigue
     * leyendo, si lo pisara saldria el reporte mezclado */
    if (huart->gState != HAL_UART_STATE_READY) { status_report_pending = 1; return; }

    float x, y;
    stepper_get_position(&x, &y);
    char xs[16], ys[16], wxs[16], wys[16];
    static char msg[100]; /* static: el tx por interrupcion sigue usando el buffer despues de salir */
    format_float3(x, xs, sizeof(xs));
    format_float3(y, ys, sizeof(ys));
    format_float3(g_off_x, wxs, sizeof(wxs));
    format_float3(g_off_y, wys, sizeof(wys));
    int len = snprintf(msg, sizeof(msg), "<%s|MPos:%s,%s,0.000|FS:0,0|WCO:%s,%s,0.000>\r\n", alarm_active ? "Alarm" : "Idle", xs, ys, wxs, wys);
    /* por interrupcion: no frena al micro 3.5 ms (eso causaba tirones) */
    HAL_UART_Transmit_IT(huart, (uint8_t*)msg, len);
}

/* tx bloqueante normal, pero antes espera a que termine el tx por
 * interrupcion del status, si no HAL devuelve BUSY y se pierde el ok */
static void uart_tx(UART_HandleTypeDef *h, uint8_t *p, uint16_t n, uint32_t to)
{
    uint32_t t0 = HAL_GetTick();
    while (h->gState != HAL_UART_STATE_READY && (HAL_GetTick() - t0) < 20) { }
    HAL_UART_Transmit(h, p, n, to);
}

/* atiende todo lo que las interrupciones dejaron pendiente (alarma,
 * bienvenida, estado). se llama desde el while principal y TAMBIEN
 * desde stepper_move_to mientras espera que termine un movimiento
 * largo. eso es lo que evita que laser grbl crea que la placa se colgo
 * ("StopResponding"): antes, durante un movimiento de varios segundos
 * no salia ningun mensaje, ahora el '?' se sigue contestando.
 *
 * es seguro transmitir ac porque siempre se llama desde el contexto del
 * main (nunca desde una isr), y los pasos los sigue dando la
 * interrupcion del timer sin que esta transmision los demore */
static void service_realtime(void)
{
    watchdog_refresh(); /* se llama desde el while principal y desde la espera de cada movimiento */
    if (alarm_message_pending) {
        alarm_message_pending = false;
        char alarm[160];
        int n = snprintf(alarm, sizeof(alarm),
            MSG_ALARM_LIMIT_FMT,
            alarm_limit_axis);
        uart_tx(&huart2, (uint8_t*)alarm, n, 100);
    }
    if (estop_message_pending) {
        estop_message_pending = false;
        uart_tx(&huart2, (uint8_t*)MSG_ALARM_ESTOP, strlen(MSG_ALARM_ESTOP), 100);
    }
    if (welcome_pending) {
        welcome_pending = 0;
        g_off_x = 0.0f; /* un reset (ctrl-x) borra el offset de trabajo */
        g_off_y = 0.0f;
        const char *welcome = MSG_WELCOME;
        uart_tx(&huart2, (uint8_t*)welcome, strlen(welcome), 100);
    }
    if (status_report_pending) {
        status_report_pending = 0;
        send_status_report(&huart2);
    }
}

/* ejecuta el movimiento que quedo "pendiente" esperando a ver si el
 * siguiente seguia la misma direccion. exit_at_cruise le dice a
 * stepper_move_to si tiene que frenar al final o no (eso ya se decidio
 * afuera, comparando con la linea que acaba de llegar).
 *
 * uso una variable static (last_entered_at_cruise) para acordarme como
 * salio el movimiento ANTERIOR, porque eso define como entra este: si
 * el anterior no freno (salio a velocidad de crucero), este tiene que
 * entrar directo a crucero tambien, sin perder tiempo acelerando de
 * nuevo de cero */
static void flush_pending_move(bool exit_at_cruise)
{
    if (!g_pending.valid) return;
    static bool last_entered_at_cruise = false;

    /* si hay alarma (final de carrera), no ejecuto nada. sin esto, una linea
     * que quedaba cargada como pendiente justo cuando saltaba la alarma se
     * ejecutaba 80 ms despues (por el timeout del while principal) y
     * motors_enable() volvia a enganchar los motores y los movia */
    if (alarm_active) {
        g_pending.valid = false;
        last_entered_at_cruise = false;
        return;
    }

    /* el estado del laser para este movimiento se fija ACA, justo antes
     * de ejecutarlo, y no cuando llego la linea. rapid = es un g0 (la
     * salida va a 0). has_laser_s = la linea traia un s nuevo (el s es
     * modal: si no viene, se sigue usando el ultimo) */
    laser_begin_segment(g_pending.is_rapid, g_pending.has_laser_s, g_pending.laser_s);

    motors_enable();
    stepper_move_to(g_pending.target_x, g_pending.target_y, g_pending.feed,
                     last_entered_at_cruise, exit_at_cruise);
    /* si la alarma corto este movimiento, el proximo (despues de $X) tiene que
     * arrancar con rampa, no directo a velocidad de crucero */
    last_entered_at_cruise = alarm_active ? false : exit_at_cruise;
    g_pending.valid = false;
}

/* esta es la funcion mas importante de todo el firmware: recibe una
 * linea de texto ya armada (sin \r\n) y decide que hacer con ella. se
 * llama una vez por cada linea de gcode que llega completa desde el
 * buffer circular */
static void process_gcode_line(char *raw_line)
{
    char *gcode_str = raw_line;
    uint8_t is_jog = 0;

    /* $X es el comando de grbl para desbloquear la alarma. lo chequeo
     * primero que nada, antes incluso de ver si hay una alarma activa,
     * porque si no nunca se podria salir de la alarma */
    if (raw_line[0] == '$' && raw_line[1] == 'X' && raw_line[2] == '\0') {
        /* con la emergencia todavia apretada no se puede desbloquear */
        if (estop_pressed()) {
            uart_tx(&huart2, (uint8_t*)MSG_ERR_ESTOP_HELD, strlen(MSG_ERR_ESTOP_HELD), 100);
            return;
        }
        estop_latched = false;
        alarm_active = false;
        uart_tx(&huart2, (uint8_t*)MSG_OK, 4, 100);
        return;
    }

    /* si esta en alarma (por un final de carrera que se activo de
     * improviso), rechazo cualquier otra cosa que llegue hasta que
     * manden $X. ni siquiera llego a parsear la linea */
    if (alarm_active) {
        const char *err = MSG_ERR_LOCKED;
        uart_tx(&huart2, (uint8_t*)err, strlen(err), 100);
        return;
    }

    /* comandos que arrancan con $ son comandos especiales de grbl, no
     * gcode normal */
    if (raw_line[0] == '$') {
        if (raw_line[1] == 'J' && raw_line[2] == '=') {
            /* $J=... es un comando de jog (los botones de flecha de
             * laser grbl mandan esto). le saco el prefijo y lo trato
             * como una linea de gcode normal de ahi en mas */
            gcode_str = &raw_line[3];
            is_jog = 1;
        } else if (raw_line[1] == 'H' && raw_line[2] == '\0') {
            /* $H es homing */
            bool ok = homing_run();
            if (ok) {
                /* homing_run ya deja todo en 0 internamente, pero lo
                 * vuelvo a fijar ac por las dudas, no cuesta nada */
                stepper_set_position(0.0f, 0.0f);
                z_axis_set_position(0.0f);
                g_off_x = 0.0f; /* despues de homing el cero anterior ya no vale */
                g_off_y = 0.0f;
                uart_tx(&huart2, (uint8_t*)MSG_OK, 4, 100);
            } else if (alarm_active) {
                /* el homing lo corto una emergencia: ya se avisa aparte, no es un "homing fallo" */
            } else {
                const char *err = MSG_ALARM_HOMING;
                uart_tx(&huart2, (uint8_t*)err, strlen(err), 100);
            }
            return;
        } else if (raw_line[1] == '$' && raw_line[2] == '\0') {
            /* $$ es "mostrame la configuracion". contesto lo minimo para
             * que laser grbl sepa que hay modo laser ($32=1), y asi
             * ofrezca M4 (potencia dinamica). $30 es la potencia maxima
             * (la misma LASER_S_MAX que uso en laser.c) y $31 la minima */
            char cfg[48];
            int n = snprintf(cfg, sizeof(cfg), "$30=%d\r\n$31=0\r\n$32=1\r\n", (int)LASER_S_MAX);
            uart_tx(&huart2, (uint8_t*)cfg, n, 100);
            uart_tx(&huart2, (uint8_t*)MSG_OK, 4, 100);
            return;
        } else {
            /* cualquier otro comando $ no esta implementado: aviso con
             * error (no es alarma, la maquina sigue andando normal) */
            uart_tx(&huart2, (uint8_t*)MSG_ERR_UNKNOWN_SYS, strlen(MSG_ERR_UNKNOWN_SYS), 100);
            return;
        }
    }

    GcodeCommand cmd = {0};
    if (gcode_parse_line(gcode_str, &cmd)) {

        /* comando no reconocido: aviso con error y ignoro la linea
         * entera. no es una alarma, la maquina no se bloquea ni se
         * apagan los motores, simplemente sigue con la linea que viene */
        if (cmd.has_unknown) {
            uart_tx(&huart2, (uint8_t*)MSG_ERR_UNKNOWN, strlen(MSG_ERR_UNKNOWN), 100);
            return;
        }

        /* tope de velocidad: si piden una F mayor al maximo, la descarto,
         * aviso con un [MSG] y la recorto al maximo. no es una
         * alarma: la linea se ejecuta igual y el trabajo sigue */
        if (cmd.has_f && cmd.f > MAX_FEED_MM_MIN) {
            char warn[64];
            int fdef = (int)MAX_FEED_MM_MIN;
            int n = snprintf(warn, sizeof(warn), MSG_WARN_FEED_FMT, (int)cmd.f, fdef);
            uart_tx(&huart2, (uint8_t*)warn, n, 100);
            cmd.f = MAX_FEED_MM_MIN;
        }

    	/* si esta linea NO es una continuacion de movimiento (viene un
    	 * g0, un cambio de z, apagar el laser, o desactivar motores),
    	 * primero tengo que ejecutar lo que haya quedado pendiente del
    	 * encadenado de segmentos. sino ese ultimo tramo se perderia o
    	 * se mezclaria mal con esta linea nueva */
    	if (cmd.has_z || cmd.has_m5 || cmd.has_m84) {
    	    flush_pending_move(false);
    	}

        /* g92 fija el origen de trabajo donde esta la maquina ahora (o
         * en el valor dado). primero termino cualquier movimiento
         * pendiente para conocer la posicion real. g92.1 borra el offset */
        if (cmd.has_g92 || cmd.has_g92_1) {
            flush_pending_move(false);
            float mx, my;
            stepper_get_position(&mx, &my);
            if (cmd.has_g92_1) {
                g_off_x = 0.0f;
                g_off_y = 0.0f;
            } else if (!cmd.has_x && !cmd.has_y) {
                g_off_x = mx;   /* g92 sin ejes: cero de trabajo aca */
                g_off_y = my;
            } else {
                if (cmd.has_x) g_off_x = mx - cmd.x;
                if (cmd.has_y) g_off_y = my - cmd.y;
            }
        }

        /* la F es modal: si viene en una linea sin movimiento (ej. "M3 S30 F1000")
         * hay que recordarla igual para los G1 que vienen despues */
        if (cmd.has_f) g_last_feed_mm_min = cmd.f;

        /* en un jog ($J=G91 X10 ...) el G90/G91 vale SOLO para esa linea y
         * no cambia el modo del programa, como en grbl. si lo cambiara,
         * despues de mover con las flechas el framing y los trabajos se
         * interpretarian como relativos */
        uint8_t abs_mode = g_absolute_mode;
        if (cmd.has_g90) abs_mode = 1;
        if (cmd.has_g91) abs_mode = 0;
        if (!is_jog) g_absolute_mode = abs_mode;
        if (cmd.has_m3 || cmd.has_m4) {
            laser_enable();
            /* m3 = potencia constante, m4 = potencia dinamica (la
             * potencia sigue a la velocidad, ver laser.c) */
            laser_set_dynamic(cmd.has_m4);
        }
        if (cmd.has_m84) {
            motors_disable();
        }
        if (cmd.has_m17) {
            motors_enable();
        }
        if (cmd.has_m5) {
            laser_disable();
        }
        /* s suelto (sin x/y): ejecuto antes el movimiento pendiente para respetar el orden */
        if (cmd.has_s && !cmd.has_x && !cmd.has_y) {
            flush_pending_move(false);
            laser_set_power(cmd.s);
        }
        uint8_t explicit_motion = (cmd.type == GCODE_G0 || cmd.type == GCODE_G1);
        if (explicit_motion) g_last_motion = cmd.type;

        /* en todo g0 apago el laser de una, sin importar si la linea
         * trae s o no. esto imita lo que hace un grbl real en modo
         * laser: nunca se quiere que el laser quede prendido durante
         * un traslado rapido, es una cuestion de seguridad. lo dejo
         * ACA (al llegar la linea) ademas de en el flush, para que el
         * laser no quede prendido y quieto en m3 mientras el g0 espera
         * en la cola */
        if (cmd.type == GCODE_G0 && !g_pending.valid) {
            laser_force_off_for_rapid();
        }

        /* should_move me dice si esta linea trae alguna coordenada de
         * x o y (gcode modal: puede venir sin g0/g1 explicito y aun
         * asi ser un movimiento valido, eso ya lo resuelve el parser) */
        uint8_t should_move = (cmd.has_x || cmd.has_y) && !cmd.has_g92;
        (void)g_last_motion; /* reservado para cuando distingamos velocidad G0 vs G1 */

        /* si hay que moverse pero los motores estan desactivados (m84),
         * aviso y no ejecuto nada. este chequeo quedo duplicado dos
         * veces seguidas de cuando lo fui armando, no hace falta pero
         * tampoco rompe nada dejarlo asi */
        if (should_move && !motors_are_enabled()) {
            const char *warn = MSG_WARN_MOTORS_OFF;
            uart_tx(&huart2, (uint8_t*)warn, strlen(warn), 100);
            should_move = 0; /* no ejecutamos el movimiento */
        }

        if (should_move) {
            float cur_x, cur_y;
            stepper_get_position(&cur_x, &cur_y);
            if (g_pending.valid) {
                /* si ya hay un movimiento pendiente en cola, calculo
                 * esta nueva linea a partir de DONDE VA A TERMINAR ese
                 * pendiente, no de donde esta la maquina ahora mismo
                 * (que todavia no se movio fisicamente) */
                cur_x = g_pending.target_x;
                cur_y = g_pending.target_y;
            }

            float target_x, target_y;
            if (abs_mode) {
                /* las coordenadas llegan en sistema de trabajo: sumo el
                 * offset para obtener la posicion real de maquina */
                target_x = cmd.has_x ? (cmd.x + g_off_x) : cur_x;
                target_y = cmd.has_y ? (cmd.y + g_off_y) : cur_y;
            } else {
                target_x = cur_x + (cmd.has_x ? cmd.x : 0.0f);
                target_y = cur_y + (cmd.has_y ? cmd.y : 0.0f);
            }

            /* limite de software del area de trabajo. esto solo tiene
             * sentido real despues de haber hecho $H, porque antes de
             * eso la posicion 0 es arbitraria y no corresponde a
             * ninguna esquina fisica de verdad */
            if (target_x < 0.0f || target_x > WORKSPACE_X_MAX_MM ||
                target_y < 0.0f || target_y > WORKSPACE_Y_MAX_MM) {
                const char *err = MSG_WARN_OUT_XY;
                uart_tx(&huart2, (uint8_t*)err, strlen(err), 100);
            } else {
                if (cmd.has_f) {
                    g_last_feed_mm_min = cmd.f;
                }
                float feed = g_last_feed_mm_min;

                /* calculo la direccion normalizada (un vector unitario)
                 * de este movimiento, para despues poder comparar con
                 * el siguiente y ver si siguen exactamente la misma
                 * direccion */
                float new_dx = target_x - cur_x;
                float new_dy = target_y - cur_y;
                float new_len = sqrtf(new_dx*new_dx + new_dy*new_dy);
                float new_dir_x = (new_len > 1e-4f) ? (new_dx / new_len) : 0.0f;
                float new_dir_y = (new_len > 1e-4f) ? (new_dy / new_len) : 0.0f;

                if (g_pending.valid) {
                    /* producto punto entre las dos direcciones: si da
                     * practicamente 1, significa que apuntan para el
                     * mismo lado exacto (colineales), asi que no hace
                     * falta frenar entre uno y otro */
                    float dot = g_pending.dir_x * new_dir_x + g_pending.dir_y * new_dir_y;
                    bool continues = (dot > 0.999f);
                    flush_pending_move(continues);
                }
                /* el g1 anterior ya termino de ejecutarse (flush es
                 * bloqueante), recien ahora apago el laser para el g0 */
                if (cmd.type == GCODE_G0) {
                    laser_force_off_for_rapid();
                }

                /* esta linea queda como la nueva pendiente, todavia no
                 * se ejecuta: se ejecuta recien cuando llegue la
                 * proxima (ahi se decide si frena o no) o si pasa
                 * mucho tiempo sin que llegue nada mas (ver el timeout
                 * en el while principal) */
                g_pending.valid = true;
                g_pending.target_x = target_x;
                g_pending.target_y = target_y;
                g_pending.feed = feed;
                g_pending.dir_x = new_dir_x;
                g_pending.dir_y = new_dir_y;
                g_pending.is_rapid = (cmd.type == GCODE_G0);
                g_pending.has_laser_s = cmd.has_s;
                g_pending.laser_s = cmd.s;
                g_last_line_tick = HAL_GetTick();
            }
        }

        /* el eje z se maneja aparte, no entra en el encadenado de
         * segmentos de x/y (normalmente se usa para ajustar el foco
         * antes de grabar, no en medio de un trazo) */
        if (cmd.has_z && !cmd.has_g92) {
            if (!motors_are_enabled()) {
                const char *warn = MSG_WARN_MOTORS_OFF;
                uart_tx(&huart2, (uint8_t*)warn, strlen(warn), 100);
            } else {
                float target_z;
                float cur_z;
                z_axis_get_position(&cur_z);
                if (abs_mode) {
                    target_z = cmd.z;
                } else {
                    target_z = cur_z + cmd.z;
                }
                float feed = cmd.has_f ? cmd.f : g_last_feed_mm_min;
                if (target_z < 0.0f || target_z > WORKSPACE_Z_MAX_MM) {
                    const char *err = MSG_WARN_OUT_Z;
                    uart_tx(&huart2, (uint8_t*)err, strlen(err), 100);
                } else {
                    z_axis_move_to(target_z, feed);
                }
            }
        }
    }
    /* respondo ok al final de cualquier linea que haya llegado hasta
     * aca (haya hecho algo o no), porque laser grbl necesita este ok
     * para saber que puede mandar la siguiente linea de la cola */
    uart_tx(&huart2, (uint8_t*)MSG_OK, 4, 100);
}

/* interrupcion de recepcion de uart: se dispara una vez por cada byte
 * que llega. ojo que esto corre en contexto de interrupcion, asi que
 * tiene que ser lo mas rapido y simple posible - por eso nunca
 * transmite nada directo, solo guarda bytes en el buffer circular o
 * prende banderas para que el main() se encargue despues */
void HAL_UART_RxCpltCallback(UART_HandleTypeDef *huart)
{
    if (huart->Instance == USART2)
    {
        if (rx_byte == '?') {
            /* '?' es un comando de "tiempo real" de grbl: no es parte
             * de una linea, pide el estado actual ya mismo. no lo meto
             * en el buffer de lineas, solo prendo la bandera */
            status_report_pending = 1;
        } else if (rx_byte == 0x18) {
            /* Ctrl-X: comando de soft-reset de Grbl. LaserGRBL lo manda
             * al conectar esperando ver de nuevo el mensaje de bienvenida. */
            welcome_pending = 1;
        } else {
            /* byte normal de gcode: lo guardo en el buffer circular.
             * si el buffer esta lleno (no deberia pasar nunca con 256
             * bytes de margen) simplemente se pierde ese byte en vez
             * de romper algo */
            uint16_t next_head = (rx_ring_head + 1) % RX_RING_SIZE;
            if (next_head != rx_ring_tail) {
                rx_ring[rx_ring_head] = rx_byte;
                rx_ring_head = next_head;
            }
        }
        HAL_UART_Receive_IT(huart, &rx_byte, 1); /* rearmo la recepcion para el proximo byte */
    }
}

/* interrupcion externa de los 3 finales de carrera. esto es lo que da
 * la parada de emergencia de verdad: si se activa un switch en medio
 * de un movimiento normal (no durante el homing a proposito), corta
 * todo al instante sin importar en que estaba ocupado el firmware en
 * ese momento */
/* confirma que el pin sigue en bajo durante window_us, usando el contador
 * de ciclos dwt (ya lo habilita homing_init, asi que tiene que estar corriendo) */
static bool limit_still_low(uint16_t pin, uint32_t window_us)
{
    uint32_t start = DWT->CYCCNT;
    uint32_t cycles = window_us * (SystemCoreClock / 1000000U);
    while ((DWT->CYCCNT - start) < cycles) {
        if (HAL_GPIO_ReadPin(GPIOB, pin) != GPIO_PIN_RESET) return false;
    }
    return true;
}

void HAL_GPIO_EXTI_Callback(uint16_t GPIO_Pin)
{
    /* parada de emergencia: va ANTES del chequeo de homing, porque tiene
     * que funcionar siempre, tambien en medio del homing */
    if (GPIO_Pin == ESTOP_Pin) {
        /* antirrebote: tiene que seguir apretado ESTOP_DEBOUNCE_US */
        uint32_t start = DWT->CYCCNT;
        uint32_t cycles = ESTOP_DEBOUNCE_US * (SystemCoreClock / 1000000U);
        while ((DWT->CYCCNT - start) < cycles) {
            if (!estop_pressed()) return; /* fue un pico, no una pulsacion real */
        }

        stepper_emergency_stop();
        z_axis_emergency_stop();
        homing_abort();
        laser_disable();
        g_pending.valid = false;
        motors_disable(); /* motores sin corriente */

        if (!estop_latched) {
            estop_latched = true;
            estop_message_pending = true; /* el mensaje lo manda el main */
        }
        alarm_active = true;
        return;
    }

    if (homing_is_active()) {
        return;
    }

    if (GPIO_Pin == X_LIMIT_PIN || GPIO_Pin == Y_LIMIT_PIN || GPIO_Pin == Z_LIMIT_PIN) {
        if (!limit_still_low(GPIO_Pin, 200)) {
            return; /* fue un pico, no un toque real */
        }

        stepper_emergency_stop();
        z_axis_emergency_stop();
        laser_disable();
        g_pending.valid = false;
        motors_disable(); /* final de carrera: motores sin corriente */

        if (!alarm_active) {
            alarm_limit_axis = (GPIO_Pin == X_LIMIT_PIN) ? 'X' : (GPIO_Pin == Y_LIMIT_PIN) ? 'Y' : 'Z';
            alarm_message_pending = true;
        }
        alarm_active = true;
    }
}
/* interrupcion del timer: se llama cada vez que vence el periodo
 * configurado, tanto para tim2 (pasos de x/y) como para tim4 (pasos de
 * z). cada uno delega a su propio modulo */
void HAL_TIM_PeriodElapsedCallback(TIM_HandleTypeDef *htim)
{
    if (htim->Instance == TIM2) {
        stepper_timer_isr();
    } else if (htim->Instance == TIM4) {
        z_axis_timer_isr();
    }
}
/* USER CODE END 4 */
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
