Nicoop/CNC_Laser_micro/(commit log)

2026-10-04 solucion a que al laser no se apagaba con el look ahead
2026-10-08 Reordenamiento de carpetas y creación del esquemático en KiCad.
    [DiagramaElectrico.kicad_pcb, DiagramaElectrico.kicad_sch]
2026-10-08 Grtáficos de las Máquinas de estado.
2026-10-08 Diagramas de Máquinas de Estado
2026-10-09 Mas esquemas agregados: - Esquematico (a color y blanco&negro) - Diagrama UML
    [DiagramaElectrico.kicad_sch]
2026-10-10 M4, G92, mensajes Grbl, tope de velocidad, watchdog IWDG y correcciones del look-ahead
2026-10-16 Update: organización de los archivos del proyecto.
2026-10-17 Parada de emergencia en PB4, correccion de alarma con movimiento pendiente, rampa tras alarma y reporte de estado
